wjb000/budget-humanoid/sim/README.md

# /sim: URDF, MuJoCo model and sim2real package for Budget-19

`budget19.xml`, `budget19.urdf`, `meshes/`, `joint_map.csv`, `mass_properties.json` are generated by `cad/sim_export.py` from the same CAD that produces the printable STLs. Do not hand-edit them; change `cad/` and re-export. Everything else here (actuator model, env, training, system-ID, domain randomisation) is hand-written and sits on top of them. **Read `SIM2REAL.md` for what is and is not validated.**

| File | What |
|---|---|
| `budget19.xml` | MuJoCo MJCF: 19 position actuators, IMU site + gyro/accelerometer/quaternion sensors, `head_cam` camera, `stand` keyframe |
| `budget19.urdf` | Same robot as URDF (Isaac Lab / Isaac Sim / PyBullet / ROS) |
| `meshes/*.obj` | Visual meshes per link in link-local frame, meters |
| `joint_map.csv` | Servo ID, joint name, parent/child, axis, safe limits, nominal limits, shaft location (mm, world) |
| `mass_properties.json` | Per-link mass, COM, inertia, and where each number came from |
| `check_mujoco.py` | Load + stand check at the zero pose |
| `actuator.py` | STS3215 model: torque-speed curve, supply sag, latency, dead band, quantisation, encoder hysteresis |
| `domain_randomization.json` | Randomisation ranges used by the env |
| `default_pose.py` / `default_pose.json` | Bent-knee ready pose (soles flat, COM over the soles) used as the policy's action offset |
| `obs.py` | Observation/action definition shared by training and the Pi runtime |
| `env.py` | Gymnasium + MuJoCo `stand` / `walk` environment |
| `train.py`, `export_policy.py`, `eval_policy.py` | PPO baseline (stable-baselines3), numpy export, evaluation vs a hold-pose baseline |
| `sysid.py` | Servo system-ID: record protocol (hardware), fit, and a synthetic selftest |

Units: meters, kilograms, radians. Zero pose = standing, arms down, legs straight. Link frames are world-aligned at the zero pose, with the origin on the joint shaft. Total mass 2.366 kg, COM about (-12, 2, 310) mm at the zero pose.

## Check it

```bash
pip install mujoco numpy scipy
python sim/check_mujoco.py                    # 5 s stand at the zero pose
python -m mujoco.viewer --mjcf=sim/budget19.xml
```

`check_mujoco.py` loads the MJCF, resets to the `stand` keyframe (all targets zero), steps 5 s, and reports center-of-mass sag, torso tilt, whether both foot soles are in contact, and actuator load as a fraction of the 2.94 N m servo stall torque. It exits non-zero if sag > 30 mm, tilt > 5 deg, or a foot loses contact. Result at the committed settings (kp 20, kv 0.5):

```
model: 21 bodies, 20 joints (1 free), 19 actuators, total mass 2.366 kg
after 5.0 s: COM z 0.309 m (start 0.312, max sag 2.8 mm), COM xy drift 4.8 mm
torso tilt: final 1.61 deg, max 1.94 deg; both feet in contact: True
RESULT: PASS - stands (position hold at zero pose)
```

This proves the model loads, the masses are sane and a stiff position hold at the zero pose is statically stable on the soles. It is not a balance controller or a walking result.

## Model details and conventions

- Joints: 19 revolute. Names `{r,l}_{hip_yaw,hip_roll,hip_pitch,knee,ankle_pitch,ankle_roll,shoulder_pitch,elbow,gripper}` plus `neck_yaw`. Servo IDs: right leg 1 to 6, left leg 7 to 12, right arm 13 to 15, left arm 16 to 18, neck 19.
- Axes and limits are per joint in `joint_map.csv`. The left side is the mirror of the right side with the **axis vector flipped**, so the same positive angle moves the left and right limb in opposite physical directions and the limits are mirrored (right knee flexes in the negative direction, left knee in the positive direction). **Use the axis column and limits per joint; do not assume left = right.** (A v2 bug where both knees and both grippers carried the same-sign limits, which let the right knee fold the wrong way, was found while building the policy default pose and fixed in `cad/robot.py`.)
- Servo models, one design: **STS3250 on hip pitch and knee (4 joints, 4.9 N m stall, 7.87 rad/s no-load, 74.5 g), STS3215 on the other 15 (2.94 N m, 4.72 rad/s, 55 g)**, both 12 V datasheet values (`joint_map.csv` columns `servo_model`, `stall_nm`, `rated_nm`, `noload_rad_s`). Masses in `mass_properties.json` use the right servo per joint.
- Actuators in the MJCF: `position` actuators with kp 20 N m/rad, kv 0.5 and the per-joint torque clamp above; joint damping 0.05, armature 0.02, friction loss 0.03. Starting values, not identified. The training env replaces these with torque motors driven by `actuator.py`.
- URDF effort/velocity limits are the per-joint stall torque and no-load speed. Rated (continuous) torque: 0.98 N m STS3215, 1.57 N m STS3250.
- Inertia: per link from the printed mesh (PLA 1.24 g/cc, 0.6 fill), the servo masses (55 g + 4 g hardware) and the electronics, with the parallel-axis theorem; `mass_properties.json` lists the parts.
- Contacts: **only the two foot soles collide** (a box per foot, friction 1.0). Torso, head and arms have no collision geometry and self-collision is off, so a fall passes through the floor. The training env ends an episode on tilt/height instead.
- Sensors: `imu` site at the BNO085 location with `imu_quat`, `imu_gyro`, `imu_acc`; `head_cam` at the head lens hole, 66 deg vertical FOV (assumed).

## Sim2real quick start

```bash
pip install mujoco numpy scipy gymnasium stable-baselines3 torch pyserial
python sim/default_pose.py                                   # (re)solve the ready pose
python sim/train.py --task stand --steps 600000 --out runs/stand0
python sim/train.py --task walk  --steps 3000000 --out runs/walk0
python sim/eval_policy.py runs/walk0 --task walk
python sim/sysid.py selftest                                 # fitting code check (synthetic data)
python deploy/test_deploy.py --policy runs/stand0            # runtime + framing against the ESP32 stand-in
```

## Isaac Lab notes

1. Convert the URDF to USD with Isaac Lab's `scripts/tools/convert_urdf.py`, `--fix-base` off, joint drive stiffness/damping 0 if you drive with your own actuator model. Meshes are OBJ in meters; keep `meshes/` next to the URDF.
2. First pass: per-joint `ImplicitActuatorCfg(effort_limit=<stall_nm>, velocity_limit=<noload_rad_s>, stiffness=20, damping=0.5)` (values in `joint_map.csv`), or a `DCMotorCfg(saturation_effort=<stall_nm>, effort_limit=<rated_nm>, velocity_limit=<noload_rad_s>)` once servo data exists. The stall number is not a continuous limit.
3. The URDF has foot collisions only (as the MJCF). Add torso/head/arm collision before enabling self-collision.
4. Use `obs.py` as the definition of the observation so a policy trained there matches `deploy/pi_runtime.py`; joint order is the MJCF actuator order (= `policy_meta.json: joint_order`).
5. Domain randomisation ranges: `domain_randomization.json`.
