wjb000/budget-humanoid/sim/joint_map.csv

servo_id | joint | parent_link | child_link | axis_x | axis_y | axis_z | lower_rad | upper_rad | nominal_lower | nominal_upper | shaft_x_mm | shaft_y_mm | shaft_z_mm | servo_model | stall_nm | rated_nm | noload_rad_s
1 | r_hip_yaw | base | r_hip_yaw_link | 0 | 0 | -1 | -0.56 | 0.28 | -0.6 | 0.6 | -40.0 | -55.0 | 317.0 | STS3215 | 2.94 | 0.98 | 4.72
2 | r_hip_roll | r_hip_yaw_link | r_hip_roll_link | 1 | 0 | 0 | -0.24 | 0.2 | -0.5 | 0.5 | -28.2 | -55.0 | 275.0 | STS3215 | 2.94 | 0.98 | 4.72
3 | r_hip_pitch | r_hip_roll_link | r_thigh | 0 | -1 | 0 | -0.6 | 0.95 | -1.0 | 1.0 | 0.0 | -66.0 | 275.0 | STS3250 | 4.9 | 1.57 | 7.87
4 | r_knee | r_thigh | r_shin | 0 | -1 | 0 | -1.9 | 0.09 | -2.0 | 0.1 | 0.0 | -107.6 | 175.0 | STS3250 | 4.9 | 1.57 | 7.87
5 | r_ankle_pitch | r_shin | r_ankle_link | 0 | 1 | 0 | -0.76 | 0.76 | -0.8 | 0.8 | 0.0 | -70.2 | 78.0 | STS3215 | 2.94 | 0.98 | 4.72
6 | r_ankle_roll | r_ankle_link | r_foot | 1 | 0 | 0 | -0.33 | 0.33 | -0.35 | 0.35 | 22.0 | -55.0 | 25.0 | STS3215 | 2.94 | 0.98 | 4.72
7 | l_hip_yaw | base | l_hip_yaw_link | 0 | 0 | -1 | -0.28 | 0.56 | -0.6 | 0.6 | -40.0 | 55.0 | 317.0 | STS3215 | 2.94 | 0.98 | 4.72
8 | l_hip_roll | l_hip_yaw_link | l_hip_roll_link | 1 | 0 | 0 | -0.2 | 0.24 | -0.5 | 0.5 | -28.2 | 55.0 | 275.0 | STS3215 | 2.94 | 0.98 | 4.72
9 | l_hip_pitch | l_hip_roll_link | l_thigh | 0 | 1 | 0 | -0.95 | 0.6 | -1.0 | 1.0 | 0.0 | 66.0 | 275.0 | STS3250 | 4.9 | 1.57 | 7.87
10 | l_knee | l_thigh | l_shin | 0 | 1 | 0 | -0.09 | 1.9 | -0.1 | 2.0 | 0.0 | 107.6 | 175.0 | STS3250 | 4.9 | 1.57 | 7.87
11 | l_ankle_pitch | l_shin | l_ankle_link | 0 | -1 | 0 | -0.76 | 0.76 | -0.8 | 0.8 | 0.0 | 70.2 | 78.0 | STS3215 | 2.94 | 0.98 | 4.72
12 | l_ankle_roll | l_ankle_link | l_foot | 1 | 0 | 0 | -0.33 | 0.33 | -0.35 | 0.35 | 22.0 | 55.0 | 25.0 | STS3215 | 2.94 | 0.98 | 4.72
13 | r_shoulder_pitch | base | r_upper_arm | 0 | -1 | 0 | -1.9 | 1.9 | -2.0 | 2.0 | -22.4 | -93.5 | 440.0 | STS3215 | 2.94 | 0.98 | 4.72
14 | r_elbow | r_upper_arm | r_forearm | 0 | 1 | 0 | -1.42 | 1.42 | -1.5 | 1.5 | 16.5 | -90.7 | 359.0 | STS3215 | 2.94 | 0.98 | 4.72
15 | r_gripper | r_forearm | r_finger | 0 | -1 | 0 | -0.47 | 0.11 | -0.5 | 0.2 | 16.5 | -128.1 | 305.0 | STS3215 | 2.94 | 0.98 | 4.72
16 | l_shoulder_pitch | base | l_upper_arm | 0 | 1 | 0 | -1.9 | 1.9 | -2.0 | 2.0 | -22.4 | 93.5 | 440.0 | STS3215 | 2.94 | 0.98 | 4.72
17 | l_elbow | l_upper_arm | l_forearm | 0 | -1 | 0 | -1.42 | 1.42 | -1.5 | 1.5 | 16.5 | 90.7 | 359.0 | STS3215 | 2.94 | 0.98 | 4.72
18 | l_gripper | l_forearm | l_finger | 0 | 1 | 0 | -0.11 | 0.47 | -0.2 | 0.5 | 16.5 | 128.1 | 305.0 | STS3215 | 2.94 | 0.98 | 4.72
19 | neck_yaw | base | head | 0 | 0 | 1 | -1.13 | 1.13 | -1.2 | 1.2 | -40.0 | 0.0 | 541.5 | STS3215 | 2.94 | 0.98 | 4.72
