wjb000/budget-humanoid/cad/step/torso_front_cover.step

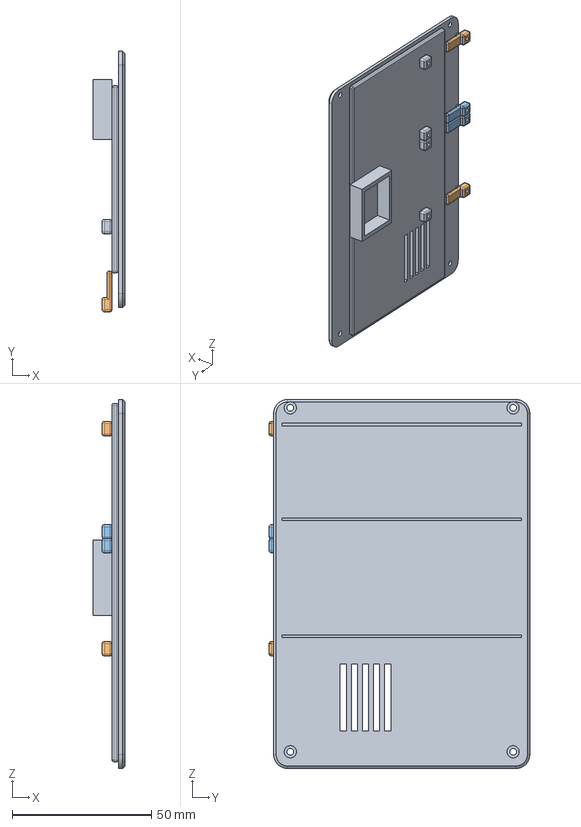
[picture p1: CAD file, 2026-11-10]
cad/step/torso_front_cover.step
11.6 x 93.6 x 132.5 mm
