wjb000/budget-humanoid/sim/meshes/r_upper_arm.obj

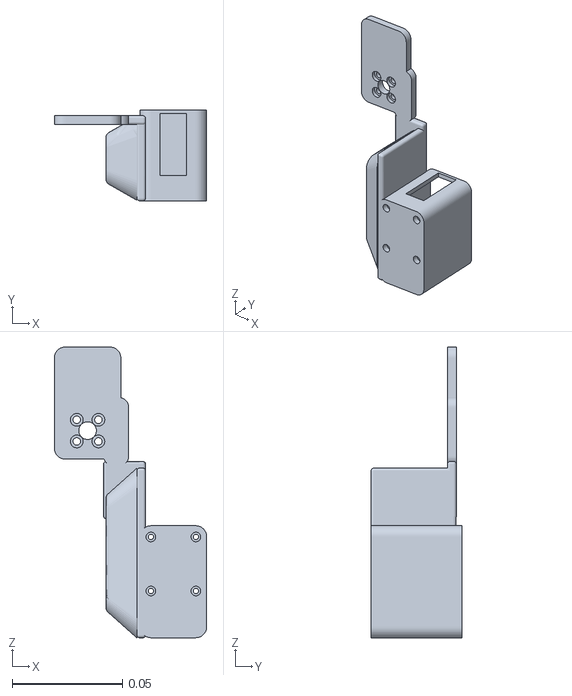
[picture p2: CAD file, 2026-11-10]
sim/meshes/r_upper_arm.obj
0.0691 x 0.0411 x 0.132
