wjb000/budget-humanoid/cad/step/torso.step

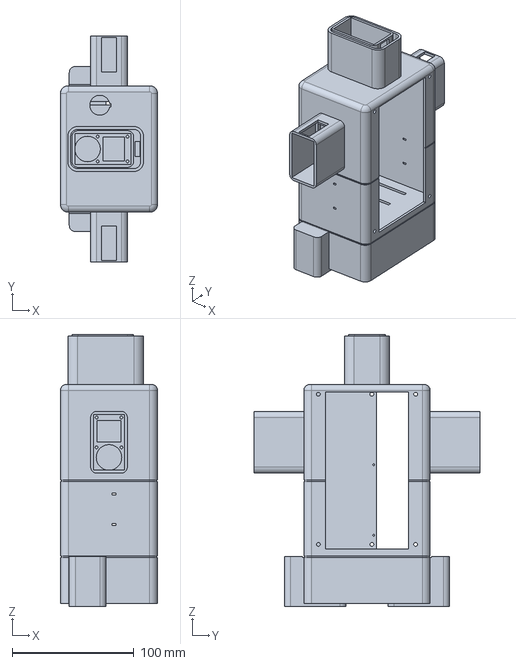
[picture p3: CAD file, 2026-11-10]
cad/step/torso.step
80.0 x 186.2 x 223.7 mm
