wjb000/budget-humanoid/sim/meshes/r_shin.obj

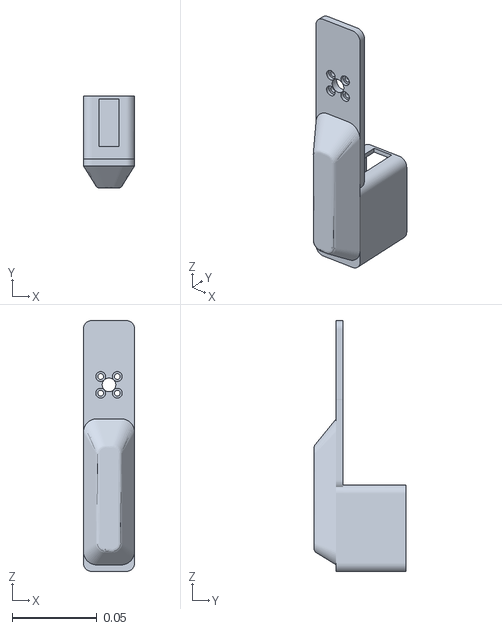
[picture p4: CAD file, 2026-11-10]
sim/meshes/r_shin.obj
0.0302 x 0.0541 x 0.148
