wjb000/budget-humanoid/cad/step/r_upper_arm.step

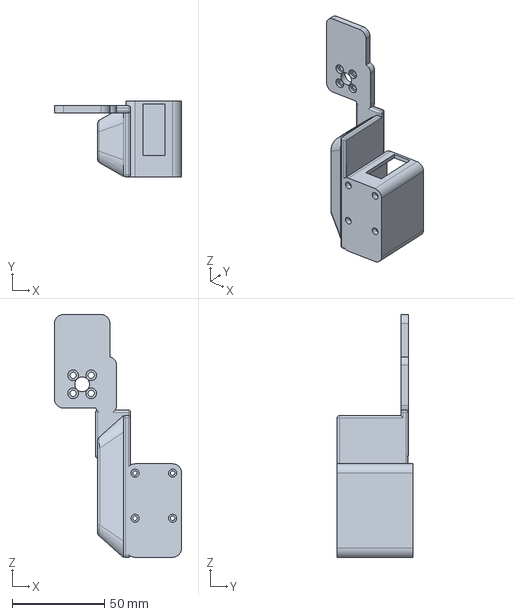
[picture p5: CAD file, 2026-11-10]
cad/step/r_upper_arm.step
69.1 x 41.1 x 131.9 mm
