wjb000/budget-humanoid/sim/meshes/r_thigh.obj

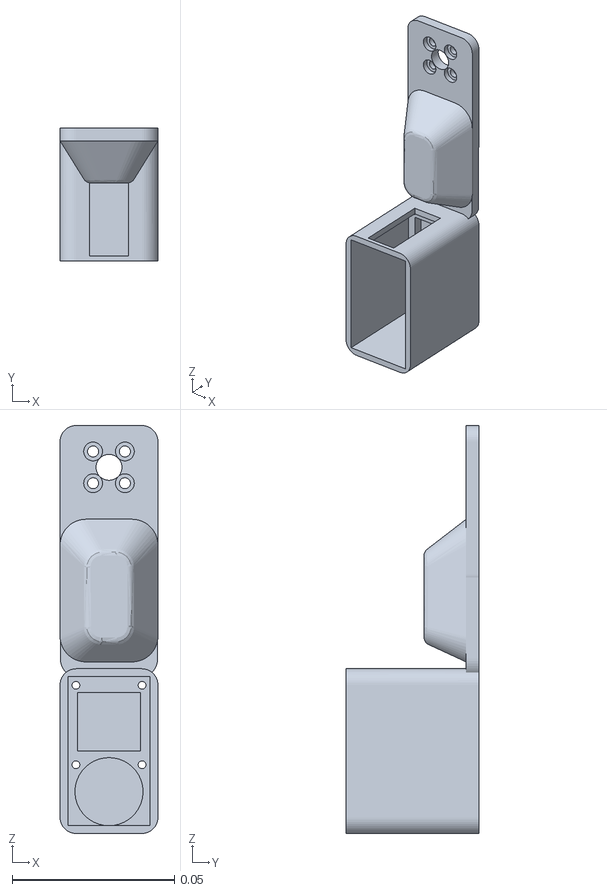
[picture p6: CAD file, 2026-11-10]
sim/meshes/r_thigh.obj
0.0302 x 0.0411 x 0.126
