wjb000/budget-humanoid/cad/step/r_thigh.step

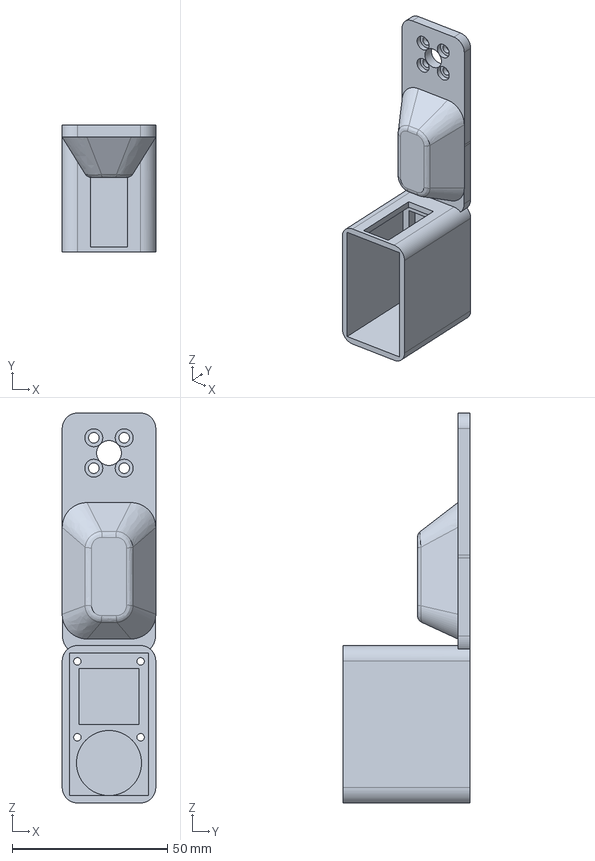
[picture p7: CAD file, 2026-11-10]
cad/step/r_thigh.step
30.2 x 41.1 x 125.8 mm
