wjb000/budget-humanoid/sim/meshes/r_forearm.obj

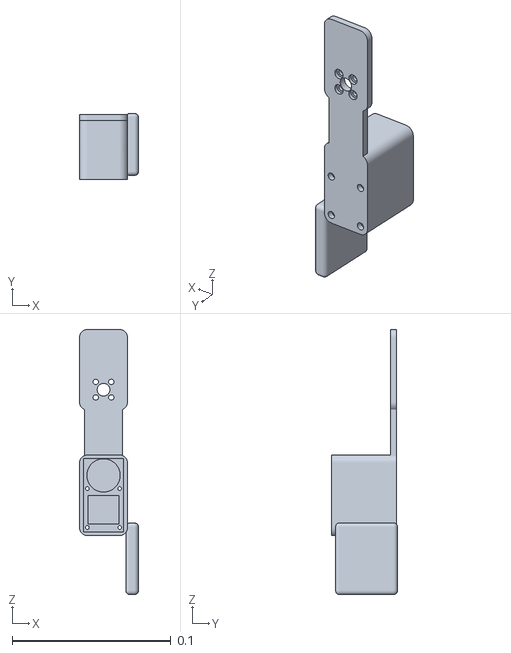
[picture p8: CAD file, 2026-11-10]
sim/meshes/r_forearm.obj
0.0371 x 0.0416 x 0.167
