wjb000/budget-humanoid/cad/step/r_shin.step

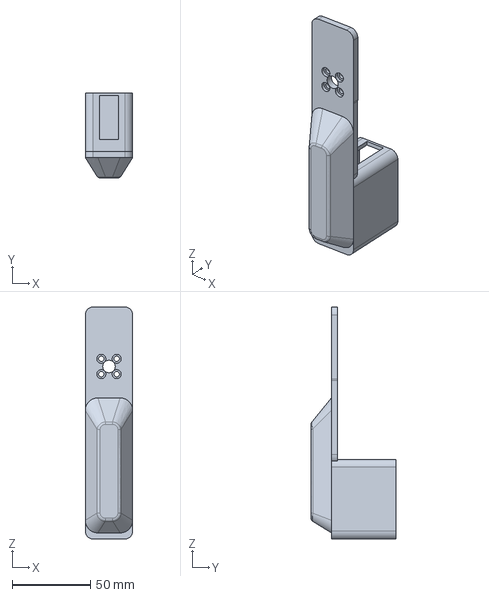
[picture p9: CAD file, 2026-11-10]
cad/step/r_shin.step
30.2 x 54.1 x 147.8 mm
