wjb000/budget-humanoid/sim/meshes/r_foot.obj

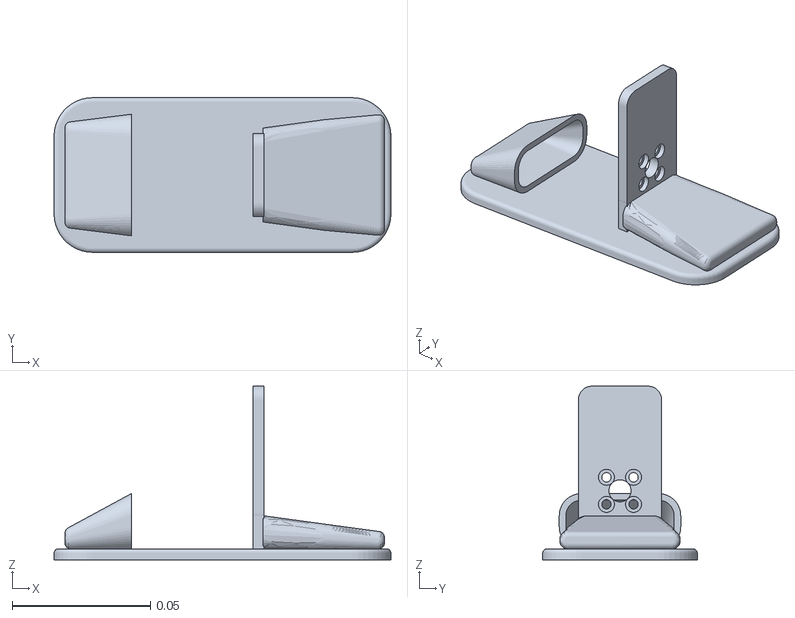
[picture p10: CAD file, 2026-11-10]
sim/meshes/r_foot.obj
0.122 x 0.056 x 0.0629
