wjb000/budget-humanoid/cad/step/r_hip_roll_link.step

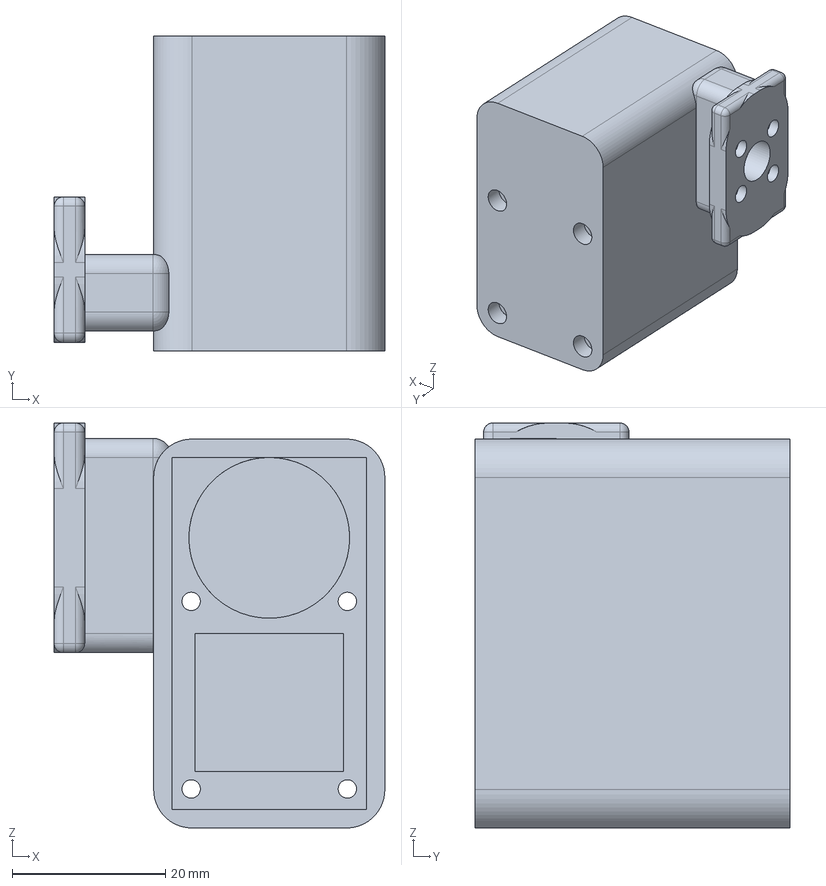
[picture p11: CAD file, 2026-11-10]
cad/step/r_hip_roll_link.step
43.2 x 41.1 x 52.9 mm
