wjb000/budget-humanoid/sim/meshes/r_hip_yaw_link.obj

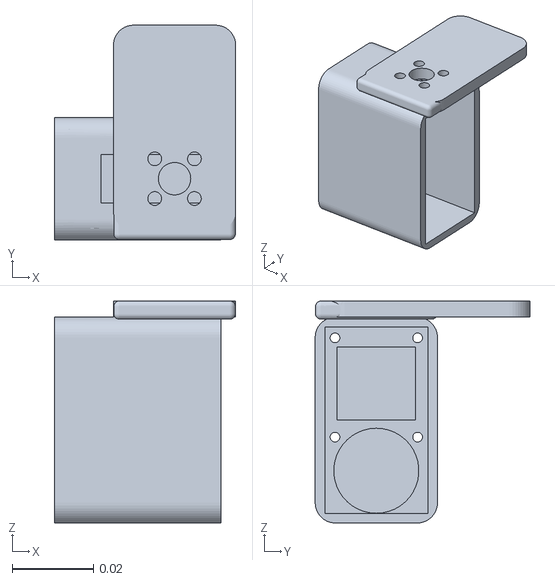
[picture p12: CAD file, 2026-11-10]
sim/meshes/r_hip_yaw_link.obj
0.0448 x 0.053 x 0.0548
