wjb000/budget-humanoid/cad/step/r_hip_yaw_link.step

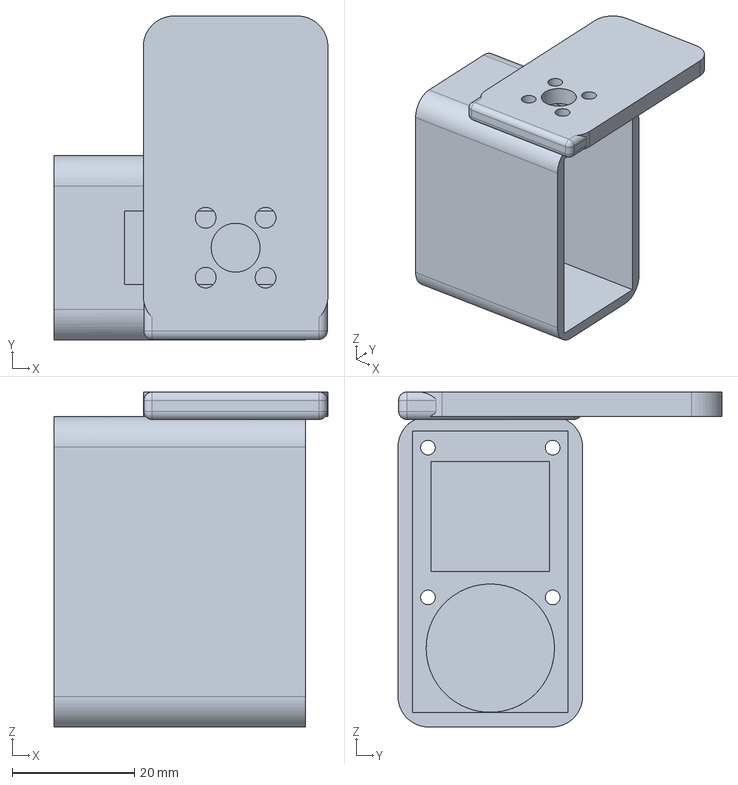
[picture p13: CAD file, 2026-11-10]
cad/step/r_hip_yaw_link.step
44.8 x 53.0 x 54.8 mm
