wjb000/budget-humanoid/sim/meshes/r_hip_roll_link.obj

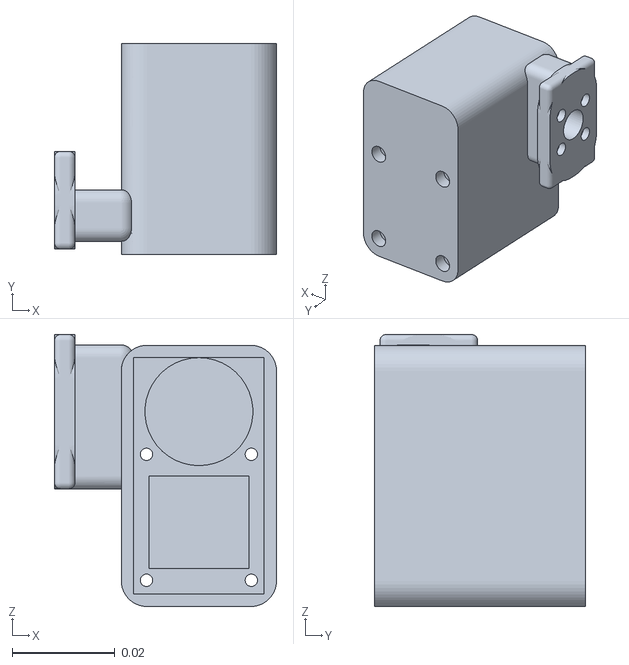
[picture p14: CAD file, 2026-11-10]
sim/meshes/r_hip_roll_link.obj
0.0432 x 0.0411 x 0.0529
