wjb000/budget-humanoid/cad/step/r_foot.step

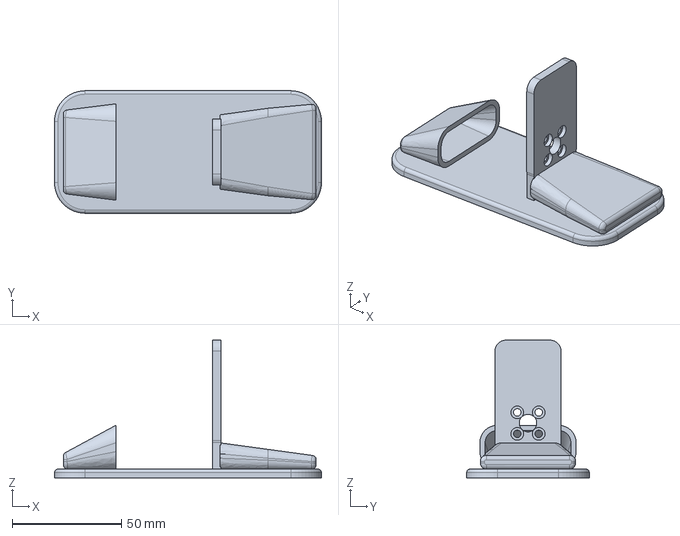
[picture p15: CAD file, 2026-11-10]
cad/step/r_foot.step
122.0 x 56.0 x 62.9 mm
