wjb000/budget-humanoid/cad/step/r_forearm.step

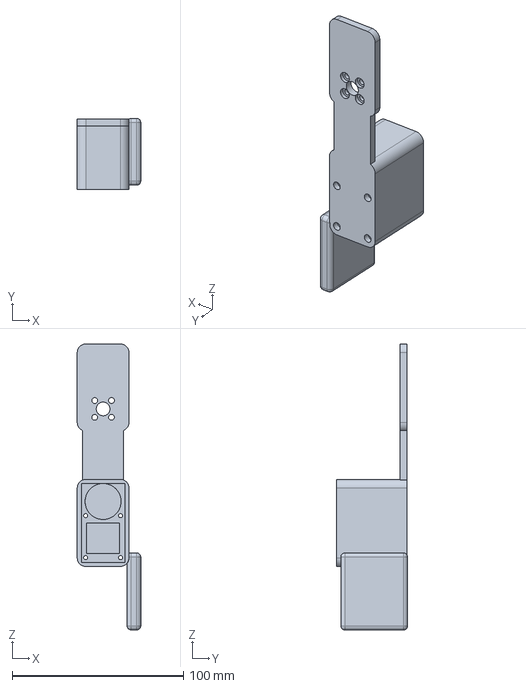
[picture p17: CAD file, 2026-11-10]
cad/step/r_forearm.step
37.1 x 41.6 x 166.9 mm
