wjb000/budget-humanoid/cad/step/r_ankle_link.step

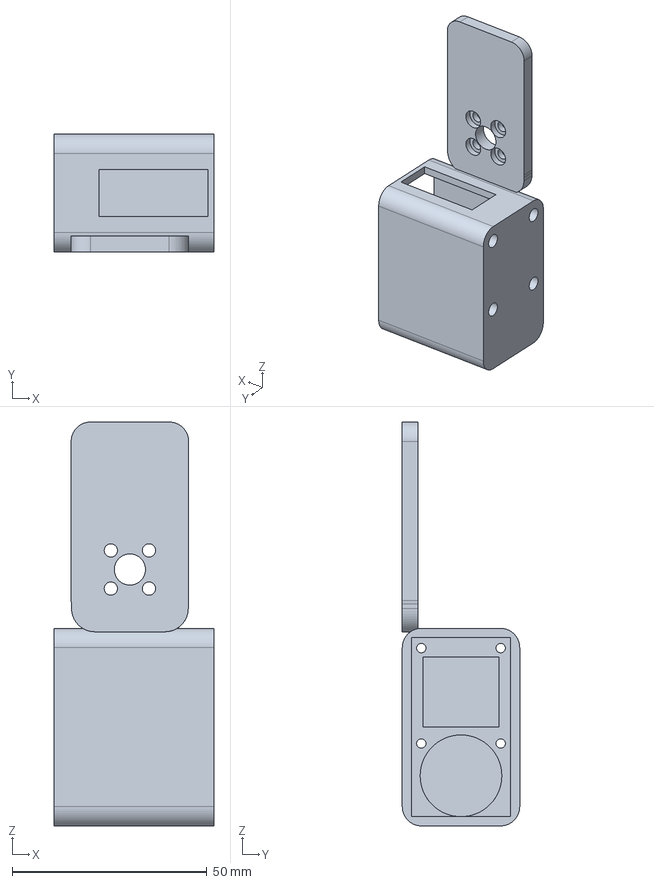
[picture p18: CAD file, 2026-11-10]
cad/step/r_ankle_link.step
41.1 x 30.2 x 103.8 mm
