wjb000/budget-humanoid/sim/meshes/r_finger.obj

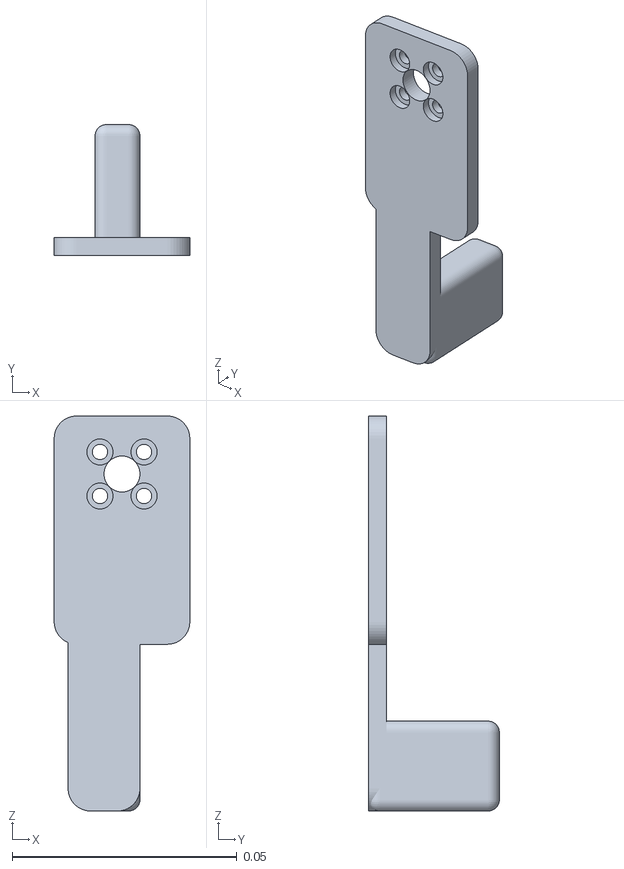
[picture p19: CAD file, 2026-11-10]
sim/meshes/r_finger.obj
0.0302 x 0.0291 x 0.0879
