wjb000/budget-humanoid/cad/step/r_finger.step

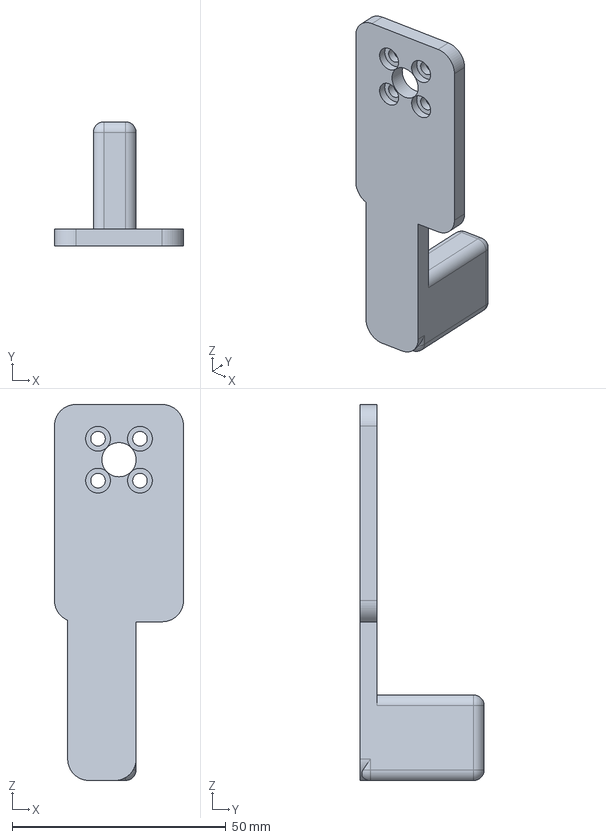
[picture p20: CAD file, 2026-11-10]
cad/step/r_finger.step
30.2 x 29.1 x 87.9 mm
