wjb000/budget-humanoid/sim/meshes/head.obj

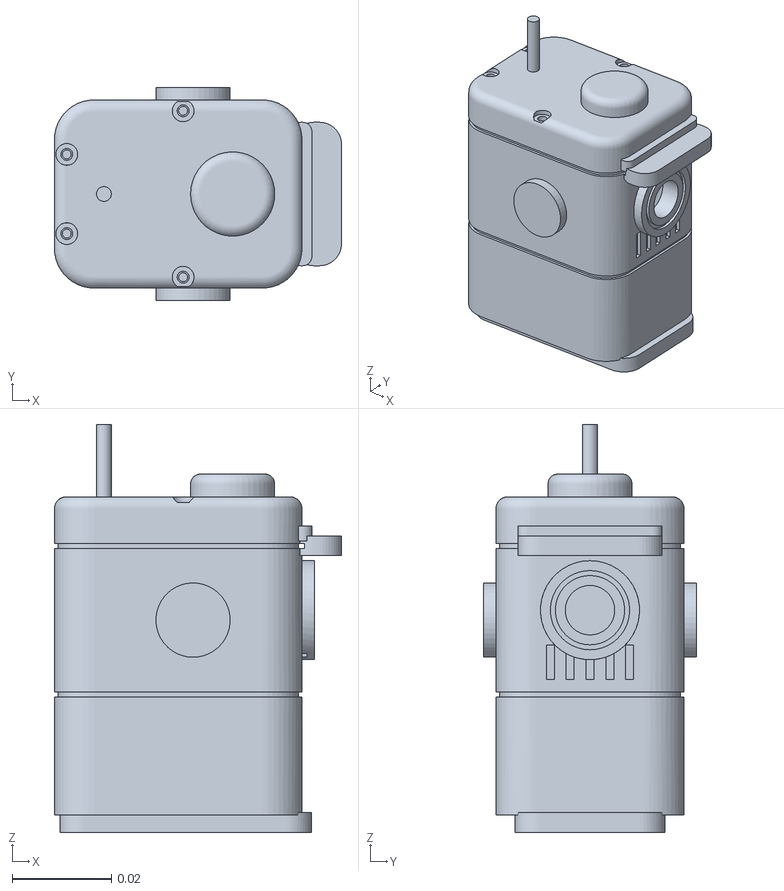
[picture p21: CAD file, 2026-11-10]
sim/meshes/head.obj
0.058 x 0.043 x 0.0824
