wjb000/budget-humanoid/cad/step/head_lid.step

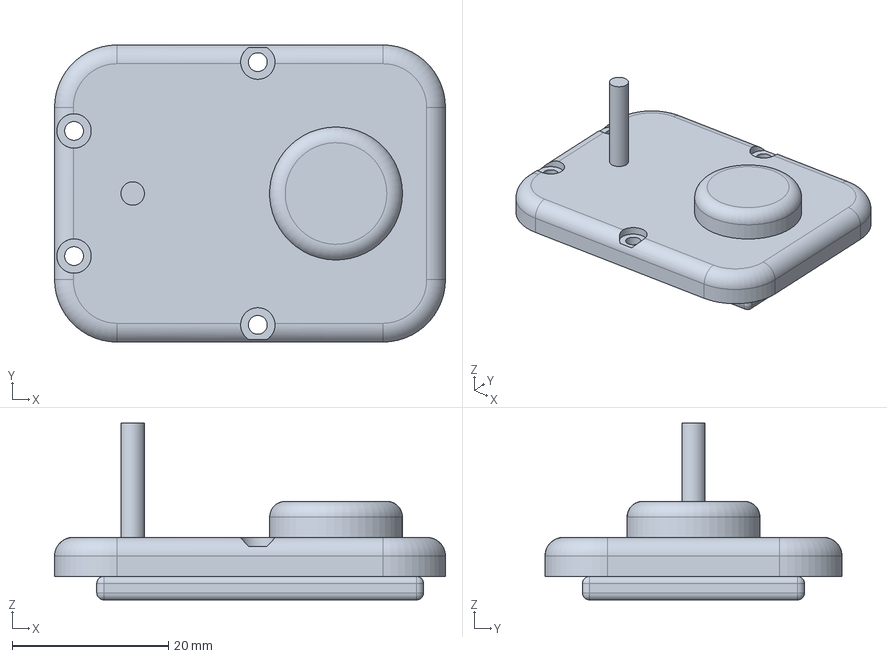
[picture p22: CAD file, 2026-11-10]
cad/step/head_lid.step
50.0 x 38.0 x 22.6 mm
