wjb000/budget-humanoid/sim/meshes/base.obj

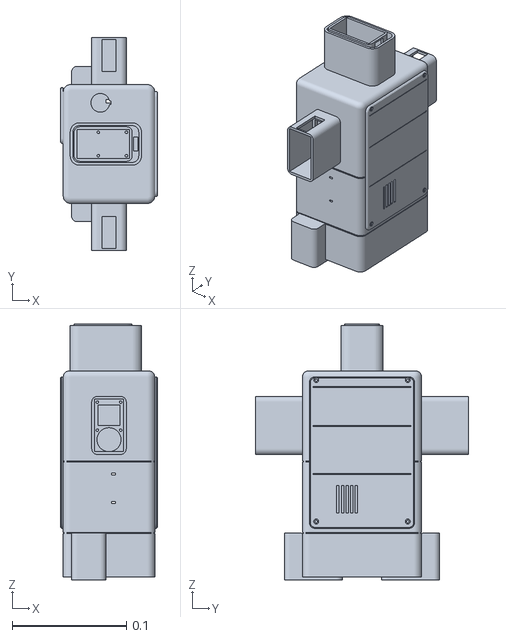
[picture p23: CAD file, 2026-11-10]
sim/meshes/base.obj
0.0848 x 0.186 x 0.224
