wjb000/budget-humanoid/cad/step/head.step

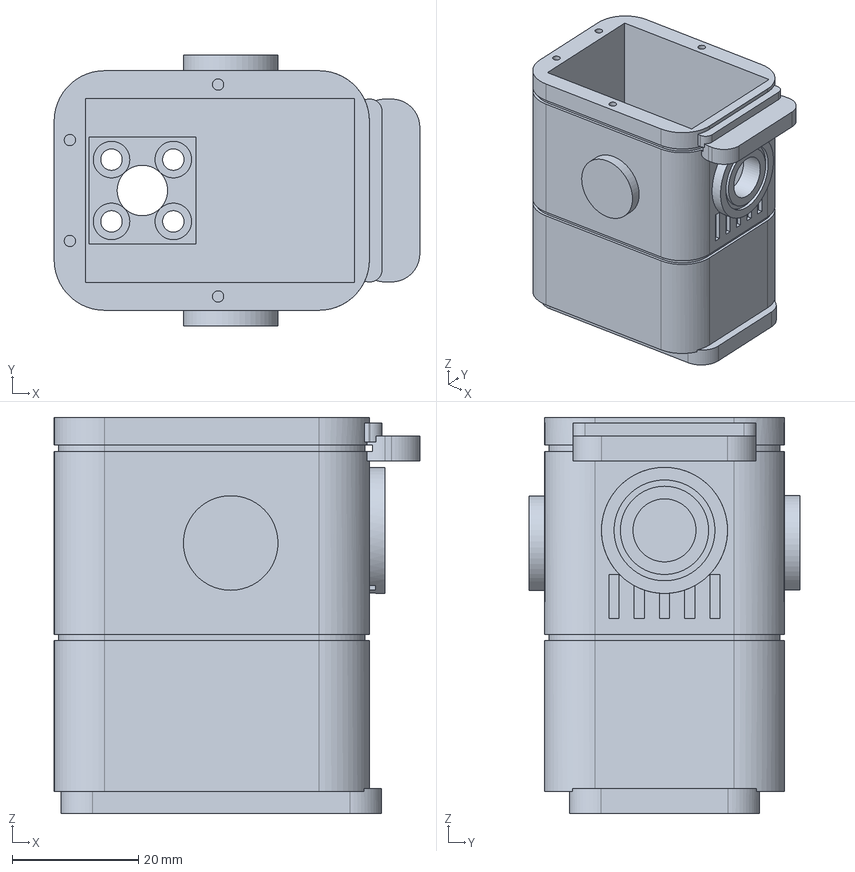
[picture p24: CAD file, 2026-11-10]
cad/step/head.step
58.0 x 43.0 x 62.8 mm
