wjb000/budget-humanoid/sim/meshes/r_shoulder_link.obj

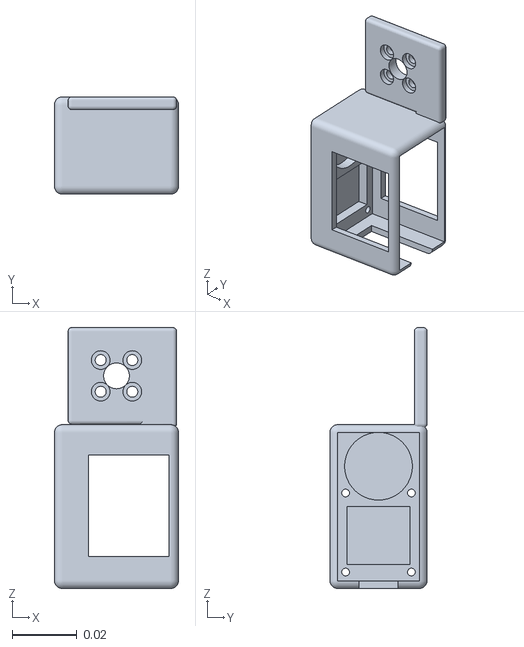
[picture p25: CAD file, 2026-11-10]
sim/meshes/r_shoulder_link.obj
0.0385 x 0.0302 x 0.0809
