wjb000/budget-humanoid/cad/step/battery_door.step

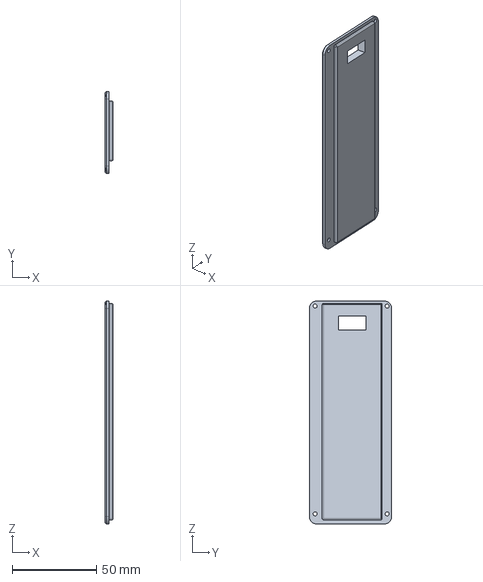
[picture p26: CAD file, 2026-11-10]
cad/step/battery_door.step
4.80 x 49.0 x 132.5 mm
