wjb000/budget-humanoid/sim/meshes/neck_bracket.obj

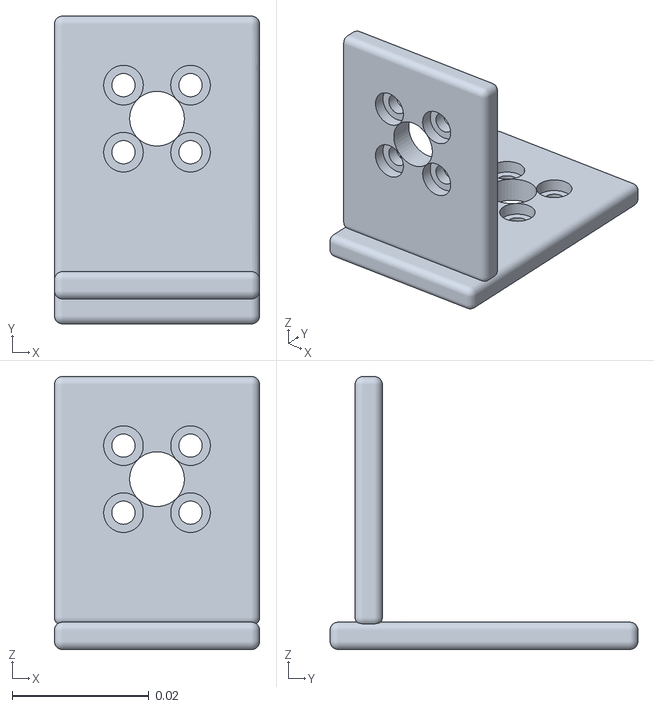
[picture p27: CAD file, 2026-11-10]
sim/meshes/neck_bracket.obj
0.03 x 0.045 x 0.0399
