wjb000/budget-humanoid/cad/step/r_shoulder_link.step

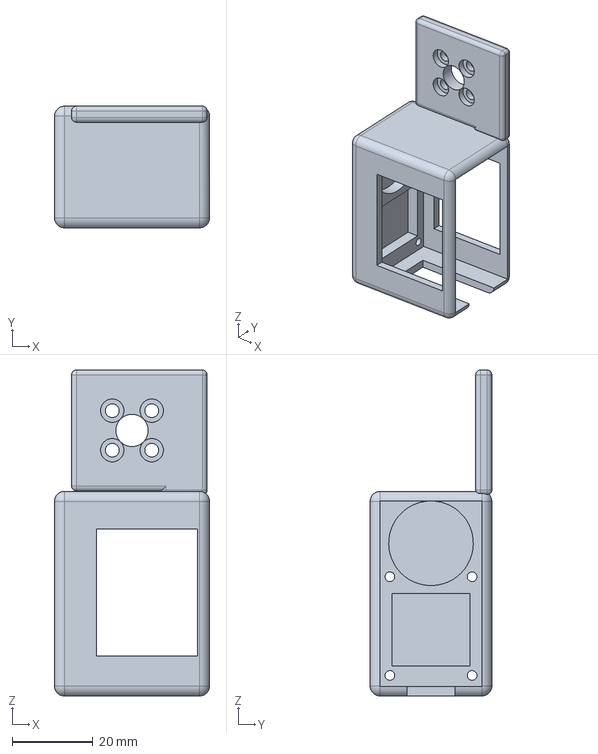
[picture p28: CAD file, 2026-11-10]
cad/step/r_shoulder_link.step
38.5 x 30.2 x 80.9 mm
