wjb000/budget-humanoid/sim/meshes/sts3215.obj

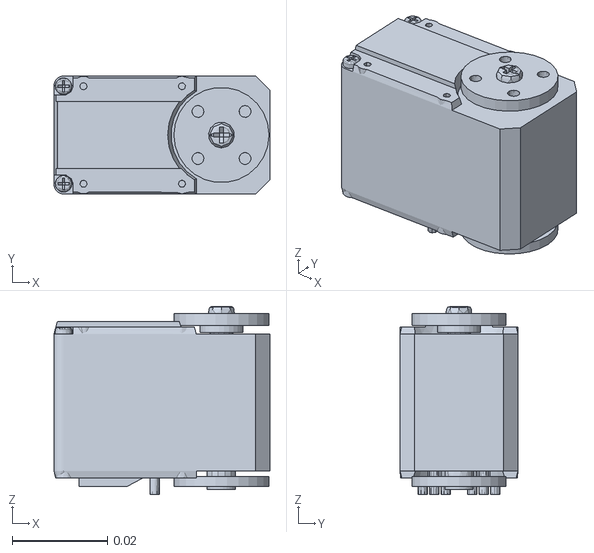
[picture p29: CAD file, 2026-11-10]
sim/meshes/sts3215.obj
0.0454 x 0.0248 x 0.0396
