wjb000/budget-humanoid/cad/step/pelvis.step

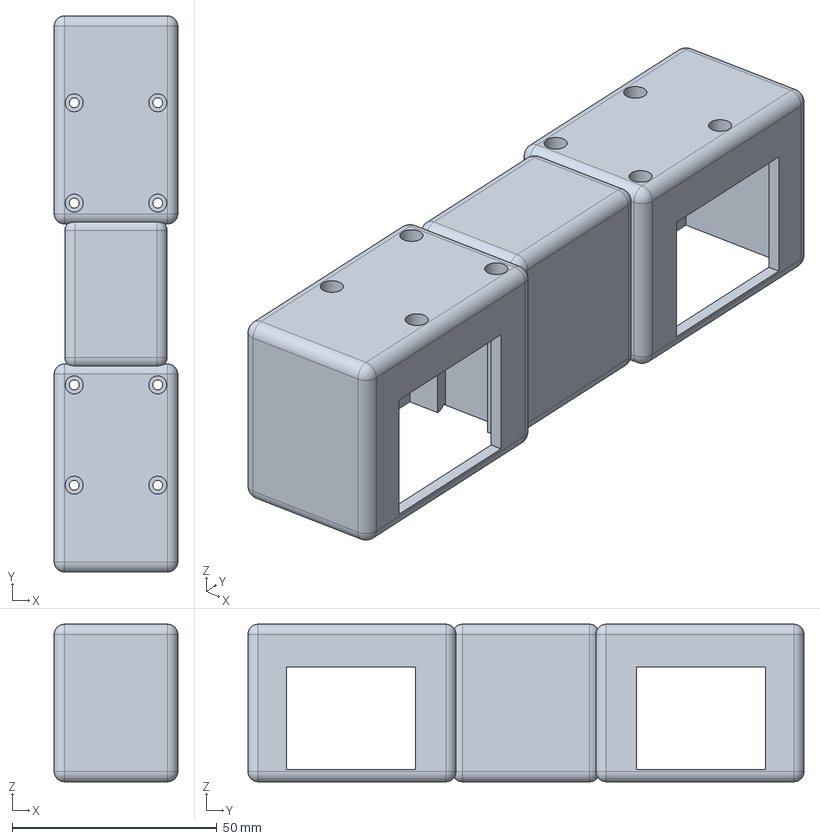
[picture p30: CAD file, 2026-11-10]
cad/step/pelvis.step
30.2 x 135.8 x 38.5 mm
