wjb000/budget-humanoid/cad/step/neck_bracket.step

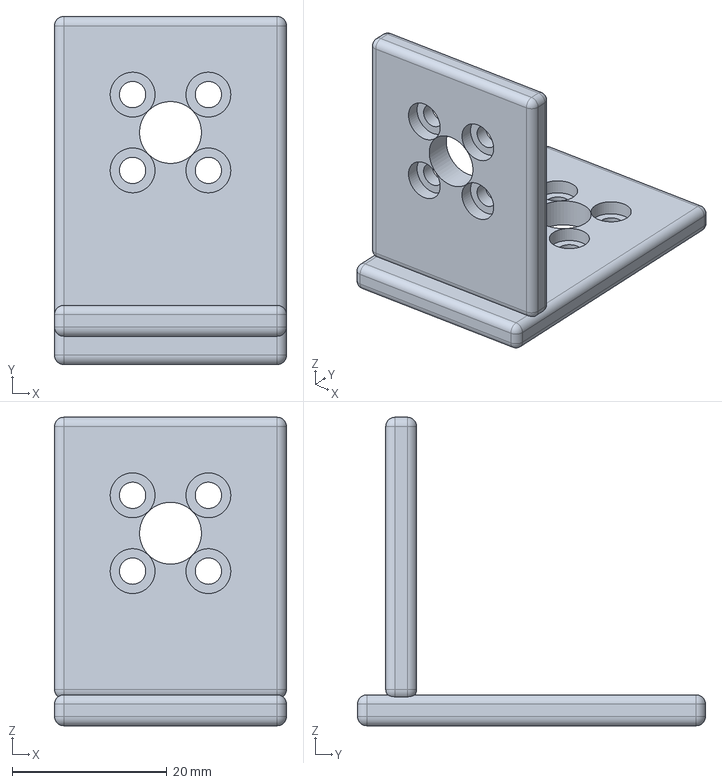
[picture p31: CAD file, 2026-11-10]
cad/step/neck_bracket.step
30.0 x 45.0 x 39.9 mm
