wjb000/budget-humanoid/cad/step/fit_coupon_sleeve.step

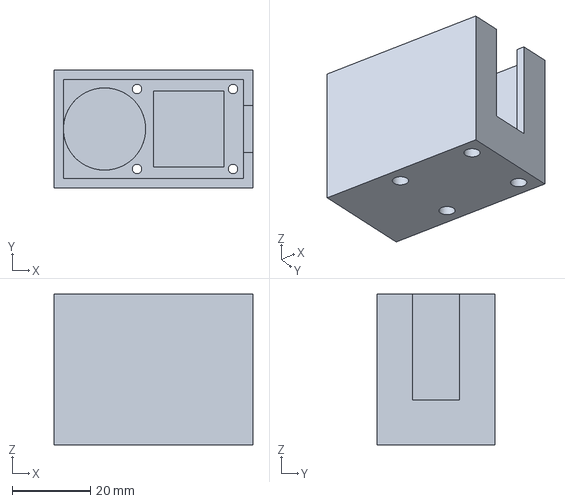
[picture p32: CAD file, 2026-11-10]
cad/step/fit_coupon_sleeve.step
50.8 x 30.2 x 38.5 mm
