wjb000/budget-humanoid/cad/step/fit_coupon_plate.step

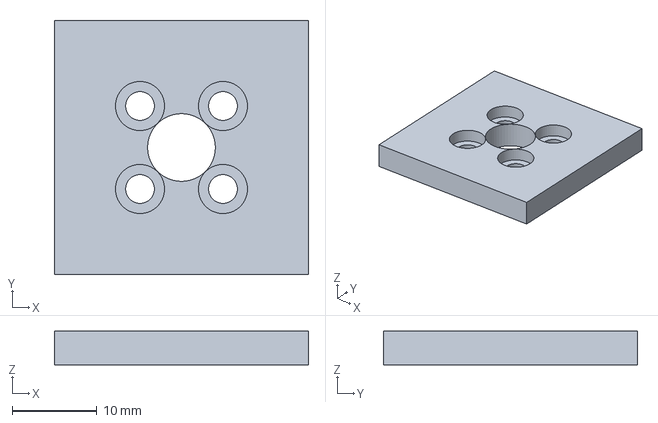
[picture p33: CAD file, 2026-11-10]
cad/step/fit_coupon_plate.step
30.0 x 30.0 x 4.00 mm
