wjb000/budget-humanoid/(list of files, cad)

Other CAD files:
sim/meshes/l_upper_arm.obj
sim/meshes/l_thigh.obj
cad/step/l_upper_arm.step
sim/meshes/l_hip_roll_link.obj
cad/step/l_thigh.step
sim/meshes/l_shin.obj
cad/step/l_shin.step
sim/meshes/l_hip_yaw_link.obj
cad/step/l_hip_roll_link.step
sim/meshes/l_forearm.obj
cad/step/l_hip_yaw_link.step
sim/meshes/l_ankle_link.obj
cad/step/l_foot.step
cad/step/l_forearm.step
sim/meshes/l_finger.obj
cad/step/l_finger.step
sim/meshes/l_foot.obj
cad/step/l_ankle_link.step
sim/meshes/l_shoulder_link.obj
cad/step/l_shoulder_link.step
cad/stl/battery_door.stl
cad/stl/fit_coupon_plate.stl
cad/stl/fit_coupon_sleeve.stl
cad/stl/head.stl
cad/stl/head_lid.stl
cad/stl/l_ankle_link.stl
cad/stl/l_finger.stl
cad/stl/l_foot.stl
cad/stl/l_forearm.stl
cad/stl/l_hip_roll_link.stl
cad/stl/l_hip_yaw_link.stl
cad/stl/l_shin.stl
cad/stl/l_shoulder_link.stl
cad/stl/l_thigh.stl
cad/stl/l_upper_arm.stl
cad/stl/neck_bracket.stl
cad/stl/pelvis.stl
cad/stl/r_ankle_link.stl
cad/stl/r_finger.stl
cad/stl/r_foot.stl
cad/stl/r_forearm.stl
cad/stl/r_hip_roll_link.stl
cad/stl/r_hip_yaw_link.stl
cad/stl/r_shin.stl
cad/stl/r_shoulder_link.stl
cad/stl/r_thigh.stl
cad/stl/r_upper_arm.stl
cad/stl/torso.stl
cad/stl/torso_front_cover.stl
