wjb000/budget-humanoid/cad/PRINT_GUIDE.md

# Print guide: Budget-19 printed frame

23 printed parts, one STL each in `cad/stl/` (ASCII STL, mm). **Every STL is already rotated into its print orientation and sits on z = 0**: import, do not rotate. Left/right parts are separate mirrored files, so print one of each file. Matching STEP files (assembly frame, for CAD work) are in `cad/step/`.

Status: **designed and checked in software only** (watertight meshes, 220 x 220 mm bed fit, collision-free zero pose, wall check). It has **not been printed or assembled** yet. Print the fit coupons first.

## 0. Fit test first (about 15 to 25 g, well under an hour)

```
python cad/fit_coupon.py          # writes cad/stl/fit_coupon_sleeve.stl and fit_coupon_plate.stl
```

1. `fit_coupon_sleeve`: a real STS3215 must drop into the pocket with the 4 case-screw holes lining up with the servo's case holes and the cable notch clear. Print **opening up**.
2. `fit_coupon_plate`: must sit on the servo horn with its 4 counterbored holes over the horn's 4 holes (9.8 mm square pattern).

The horn hole pattern, case-screw positions and cable-slot position were **measured from the SO-ARM100 STS3215 STEP**, not from a physical servo. If a coupon is off, change `HORN_PATTERN`, `CASE_HOLES`, `CLR` or `GAP` in `cad/lib.py`, run `python cad/export.py`, and every part updates.

## 1. Settings

| | |
|---|---|
| Printer | any FDM, 220 x 220 mm bed or larger (largest part: torso, see table) |
| Material | PLA+ or PETG for the frame. PETG for feet, ankle and shin (impact, creep). Not plain PLA near the battery or in a hot car. |
| Nozzle / layer | 0.4 mm / 0.2 mm |
| Perimeters | 4 (1.6 mm) minimum; designed wall is 2.0 to 2.4 mm |
| Infill | 20% gyroid; 40% for the load-bearing leg parts (thigh, shin, ankle link, foot) |
| Top/bottom | 5 layers |
| Supports | Mostly none: overhang area is under 12% on every part (forearm is the worst). The pockets open toward +z or sideways; turn on "supports touching build plate" or tree supports and read the preview for torso and forearm. |
| Tolerance | pocket clearance 0.3 mm per side, horn-plate gap 0.1 mm (set in `cad/lib.py`) |
| Printed mass | about 746 g estimated (60% effective fill), roughly 23 parts |

## 2. Parts

| Part | Qty | Servos it carries | Print size (mm) | Overhang | Est. mass* | Supports |
|---|---|---|---|---|---|---|
| `r_foot` | 1 | - | 122 x 63 x 56 | 5.1% | 36 g | supports on cable/screw pockets (see preview) |
| `r_ankle_link` | 1 | r_ankle_roll | 104 x 30 x 41 | 2.0% | 18 g | none needed |
| `r_shin` | 1 | r_ankle_pitch | 30 x 54 x 148 | 4.8% | 28 g | tree/touching-bed supports, check preview |
| `r_thigh` | 1 | r_knee | 30 x 126 x 41 | 1.8% | 23 g | none needed |
| `r_hip_roll_link` | 1 | r_hip_pitch | 43 x 53 x 41 | 3.2% | 17 g | tree/touching-bed supports, check preview |
| `r_hip_yaw_link` | 1 | r_hip_roll | 55 x 53 x 45 | 2.0% | 18 g | none needed |
| `r_upper_arm` | 1 | r_elbow | 69 x 41 x 132 | 8.3% | 31 g | supports on cable/screw pockets (see preview) |
| `r_forearm` | 1 | r_gripper | 37 x 42 x 167 | 8.9% | 30 g | supports on cable/screw pockets (see preview) |
| `r_finger` | 1 | - | 30 x 88 x 29 | 1.1% | 10 g | none needed |
| `l_foot` | 1 | - | 122 x 63 x 56 | 5.1% | 36 g | supports on cable/screw pockets (see preview) |
| `l_ankle_link` | 1 | l_ankle_roll | 104 x 30 x 41 | 2.0% | 18 g | none needed |
| `l_shin` | 1 | l_ankle_pitch | 30 x 54 x 148 | 4.8% | 28 g | tree/touching-bed supports, check preview |
| `l_thigh` | 1 | l_knee | 30 x 126 x 41 | 1.8% | 23 g | none needed |
| `l_hip_roll_link` | 1 | l_hip_pitch | 43 x 53 x 41 | 3.2% | 17 g | tree/touching-bed supports, check preview |
| `l_hip_yaw_link` | 1 | l_hip_roll | 55 x 53 x 45 | 2.0% | 18 g | none needed |
| `l_upper_arm` | 1 | l_elbow | 69 x 41 x 132 | 8.4% | 31 g | supports on cable/screw pockets (see preview) |
| `l_forearm` | 1 | l_gripper | 37 x 42 x 167 | 8.9% | 30 g | supports on cable/screw pockets (see preview) |
| `l_finger` | 1 | - | 30 x 88 x 29 | 1.1% | 10 g | none needed |
| `torso` | 1 | r_hip_yaw, l_hip_yaw, r_shoulder_pitch, l_shoulder_pitch, neck_yaw | 80 x 186 x 224 | 10.3% | 214 g | supports on cable/screw pockets (see preview) |
| `head` | 1 | - | 58 x 43 x 63 | 4.4% | 44 g | tree/touching-bed supports, check preview |
| `torso_front_cover` | 1 | - | 12 x 94 x 132 | 3.2% | 37 g | tree/touching-bed supports, check preview |
| `battery_door` | 1 | - | 5 x 49 x 132 | 1.6% | 19 g | none needed |
| `head_lid` | 1 | - | 23 x 38 x 50 | 5.2% | 10 g | supports on cable/screw pockets (see preview) |

\* Mass estimate = solid volume x 1.24 g/cc (PLA) x 0.6 effective fill. Weigh your parts and update `PLA_DENSITY`/`FILL` in `cad/export.py` so the sim masses match.

## 3. Hardware (not printed)

- 15 x Feetech STS3215 (30 kg.cm) and 4 x Feetech STS3250 (50 kg.cm) servos. The STS3250 goes on hip pitch (IDs 3, 9) and knee (IDs 4, 10). Both are 45.2 x 24.7 x 35 mm with the same 25T horn, so the pods are the same; the STS3250 mounting holes were not checked against a physical unit, so run the sleeve coupon with an STS3250 too.
- 4 x M2 screws per servo for the sleeve (case holes), self-tapping into the servo case, length about 8 to 10 mm (confirm with the sleeve coupon)
- 4 x M3 screws per servo for the horn plate (the plate holes are counterbored from the outside), length about 8 mm. Confirm against your servo's horn.
- **Fasteners are M2 and M3 only.**
  - Servo sleeves: 4 x M2 x 8 per servo (76 for 19 servos), self-tapping into the servo case. Horn plates: 4 x M3 x 8 per servo (76), plate holes counterbored from outside. Confirm both against the coupons and your servo.
  - Torso front cover: 4 x M2 x 6 into 4 x M2 heat-set inserts (pockets 3.2 mm, 6.5 mm deep) in the front bosses. Battery door: 4 x M2 x 6 into 4 more inserts. That is 8 inserts and 8 screws.
  - Head lid: 4 x M2 x 8 self-tapping into 1.8 mm pilot holes (2 in the head's back wall, 2 in its side walls).
  - Pi 5: 4 x M2 x 8 self-tapping into 1.7 mm pilot holes in the 4 torso standoffs. The Pi's own holes are M2.5 (2.75 mm), so M2 screws fit loosely; they hold, they do not locate. Check and shim if the board rocks.
  - Waveshare bus adapters A and B: 4 x M2 x 6 each into 8 M2 self-tapping bosses on the inside of the front cover (37 x 28 mm hole pattern; the board holes are 2.5 mm, so the screws locate loosely).
  - No bearings are used. Opposite-horn bearing supports are not designed (see `cad/README.md`, known gap 8).
- Battery: 3S 2200 mAh (assumed 105 x 35 x 25 mm) sits between two printed ribs in the rear bay and is held by 2 hook-and-loop straps through the floor slots. 2.5 x 100 mm cable ties (about 30) go through the tie slots in the thigh, shin and torso side walls.
- E-stop: 16 mm panel-mount unibody mushroom button (IDEC X6/XA outline, 30 mm head) in the 16.2 mm top plate hole (the key notch stops it turning). XT60 panel-mount connector (about $1.20) in the battery door cutout (15.8 x 8.2 mm). Both are envelopes in the model.
- XIAO ESP32-S3 snaps between the rails on the inside of the front cover (it has no mounting holes, so this is a friction fit; add a dab of hot glue if it rattles).
- Electronics are modeled as real vendor CAD (Pi 5, BNO085 IMU, MAX98357 amp, speaker) or as clearly marked size envelopes (camera, XIAO, buck converter, battery, bus adapters, mic, e-stop); see `cad/README.md`.

## 4. Assembly order

1. Fit-test, then print all parts.
2. Fit servos in sleeves (screws into the case holes), horn plate on each horn.
3. Press the 8 M2 heat-set inserts into the torso bosses (soldering iron, 220 C for PLA). Mount the Pi on its standoffs, the battery between the ribs, then close the battery door and the front cover.
4. Build each leg from the foot up (foot, ankle link, shin, thigh, hip roll link, hip yaw link), arms from the hand down, then the torso (it includes the pelvis) and the head (it includes the neck bracket).
5. Run servo ID setup (`sim/joint_map.csv` has the ID, name, direction and limit for each joint) **before** closing the sleeves, since servos must be daisy-chained with IDs 1 to 19.
5. Zero pose: all servos at their mid position (2048 counts) is the URDF/MJCF zero pose. Mount horns at that position.

## 5. Safe joint ranges

The ranges in `sim/joint_map.csv` come from a collision sweep of the final geometry (one joint at a time, others at zero). Combined motions are not checked. Hip yaw and roll are intentionally narrow (the legs are close together), and the arms cannot cross the torso.
