wjb000/budget-humanoid/sim/budget19.urdf

<?xml version="1.0"?>
<!-- Budget-19 humanoid. Generated by cad/sim_export.py. Units: m, kg, rad. Link frames are world-aligned at zero pose, origin at the joint shaft. -->
<robot name="budget19">
  <material name="printed"><color rgba="0.78 0.80 0.84 1"/></material>
  <material name="servo"><color rgba="0.17 0.18 0.21 1"/></material>
  <link name="base">
    <inertial><origin xyz="-0.0252444 0.00404039 0.418896" rpy="0 0 0"/><mass value="0.982852"/>
      <inertia ixx="0.00483797" ixy="-1.70004e-05" ixz="-0.000154384" iyy="0.00362709" iyz="-8.59185e-05" izz="0.00199682"/></inertial>
    <visual><origin xyz="0 0 0" rpy="0 0 0"/><geometry><mesh filename="meshes/base.obj"/></geometry><material name="printed"/></visual>
    <visual name="r_hip_yaw_servo"><origin xyz="-0.04 -0.0425 0.3357" rpy="3.14159 0 -1.5708"/><geometry><mesh filename="meshes/sts3215.obj"/></geometry><material name="servo"/></visual>
    <visual name="l_hip_yaw_servo"><origin xyz="-0.04 0.0425 0.3357" rpy="3.14159 0 1.5708"/><geometry><mesh filename="meshes/sts3215.obj"/></geometry><material name="servo"/></visual>
    <visual name="r_shoulder_pitch_servo"><origin xyz="-0.0224 -0.0748 0.4525" rpy="1.5708 1.5708 0"/><geometry><mesh filename="meshes/sts3215.obj"/></geometry><material name="servo"/></visual>
    <visual name="l_shoulder_pitch_servo"><origin xyz="-0.0224 0.0748 0.4525" rpy="-1.5708 1.5708 0"/><geometry><mesh filename="meshes/sts3215.obj"/></geometry><material name="servo"/></visual>
    <visual name="neck_yaw_servo"><origin xyz="-0.0275 0 0.5228" rpy="0 0 -3.14159"/><geometry><mesh filename="meshes/sts3215.obj"/></geometry><material name="servo"/></visual>
    <visual name="env_Raspberry_Pi_5"><origin xyz="-0.0457877 -0.0181767 0.416498"/><geometry><box size="0.0183011 0.0573984 0.0879215"/></geometry><material name="m_compute"><color rgba="0.12 0.44 0.88 1"/></material></visual>
    <visual name="env_3S_LiPo_2200_mAh_typical_outline"><origin xyz="-0.02 0.026 0.4215"/><geometry><box size="0.025 0.035 0.117"/></geometry><material name="m_power"><color rgba="0.91 0.44 0.04 1"/></material></visual>
    <visual name="env_Pololu_D24V50F5_5_V_buck"><origin xyz="0.0108 0.035 0.385"/><geometry><box size="0.0088 0.0203 0.0178"/></geometry><material name="m_power"><color rgba="0.91 0.44 0.04 1"/></material></visual>
    <visual name="env_Waveshare_bus_adapter_A_legs"><origin xyz="0.0054 -0.031 0.42275"/><geometry><box size="0.0126 0.033 0.0445"/></geometry><material name="m_compute"><color rgba="0.12 0.44 0.88 1"/></material></visual>
    <visual name="env_Waveshare_bus_adapter_B_arms_neck"><origin xyz="0.0054 -0.031 0.46475"/><geometry><box size="0.0126 0.033 0.0445"/></geometry><material name="m_compute"><color rgba="0.12 0.44 0.88 1"/></material></visual>
    <visual name="env_Seeed_XIAO_ESP32-S3"><origin xyz="0.01165 0.025 0.431"/><geometry><box size="0.0042 0.0178 0.0225"/></geometry><material name="m_compute"><color rgba="0.12 0.44 0.88 1"/></material></visual>
    <visual name="env_Relay_+_fuse_holder"><origin xyz="-0.025 -0.032 0.378"/><geometry><box size="0.02 0.02 0.03"/></geometry><material name="m_power"><color rgba="0.91 0.44 0.04 1"/></material></visual>
    <visual name="env_Adafruit_BNO085_IMU"><origin xyz="-0.01 -0.00462166 0.363884"/><geometry><box size="0.0254 0.0221033 0.00276795"/></geometry><material name="m_sensor"><color rgba="0.1 0.6 0.33 1"/></material></visual>
    <visual name="env_40_mm_speaker"><origin xyz="0.00266165 -0.012772 0.388053"/><geometry><box size="0.0250343 0.0397942 0.0399567"/></geometry><material name="m_sensor"><color rgba="0.1 0.6 0.33 1"/></material></visual>
    <visual name="env_MAX98357A_I2S_amp"><origin xyz="0.013774 -0.00250923 0.41999"/><geometry><box size="0.00234808 0.0174158 0.01778"/></geometry><material name="m_sensor"><color rgba="0.1 0.6 0.33 1"/></material></visual>
    <visual name="env_E-stop_16_mm_unibody,_NC,_latching"><origin xyz="-0.03 0.036 0.49855"/><geometry><box size="0.03 0.0299161 0.0441"/></geometry><material name="m_power"><color rgba="0.91 0.44 0.04 1"/></material></visual>
    <visual name="env_XT60_panel_connector_charge_port"><origin xyz="-0.0558 0.026 0.482"/><geometry><box size="0.018 0.016 0.0081"/></geometry><material name="m_power"><color rgba="0.91 0.44 0.04 1"/></material></visual>
  </link>
  <link name="r_foot">
    <inertial><origin xyz="-0.00793475 9.90203e-09 -0.0163007" rpy="0 0 0"/><mass value="0.0354951"/>
      <inertia ixx="1.26238e-05" ixy="3.61196e-11" ixz="-1.07029e-06" iyy="4.89843e-05" iyz="1.65015e-11" izz="5.01619e-05"/></inertial>
    <visual><origin xyz="0 0 0" rpy="0 0 0"/><geometry><mesh filename="meshes/r_foot.obj"/></geometry><material name="printed"/></visual>
    <collision><origin xyz="-0.011 0 -0.023"/><geometry><box size="0.122 0.056 0.004"/></geometry></collision>
  </link>
  <link name="r_ankle_link">
    <inertial><origin xyz="0.00191297 0.0144518 -0.0374398" rpy="0 0 0"/><mass value="0.0769925"/>
      <inertia ixx="3.14209e-05" ixy="-1.1018e-07" ixz="6.09626e-07" iyy="3.46897e-05" iyz="2.84812e-06" izz="1.39515e-05"/></inertial>
    <visual><origin xyz="0 0 0" rpy="0 0 0"/><geometry><mesh filename="meshes/r_ankle_link.obj"/></geometry><material name="printed"/></visual>
    <visual name="r_ankle_roll_servo"><origin xyz="0.0033 0.0152 -0.0405" rpy="-0 1.5708 0"/><geometry><mesh filename="meshes/sts3215.obj"/></geometry><material name="servo"/></visual>
  </link>
  <link name="r_shin">
    <inertial><origin xyz="8.29409e-08 0.0135404 -0.0760556" rpy="0 0 0"/><mass value="0.0870581"/>
      <inertia ixx="7.97093e-05" ixy="-1.90935e-11" ixz="-2.70447e-10" iyy="7.01483e-05" iyz="1.26417e-05" izz="2.09551e-05"/></inertial>
    <visual><origin xyz="0 0 0" rpy="0 0 0"/><geometry><mesh filename="meshes/r_shin.obj"/></geometry><material name="printed"/></visual>
    <visual name="r_ankle_pitch_servo"><origin xyz="0 0.0187 -0.0845" rpy="-1.5708 1.5708 0"/><geometry><mesh filename="meshes/sts3215.obj"/></geometry><material name="servo"/></visual>
  </link>
  <link name="r_thigh">
    <inertial><origin xyz="-8.7768e-08 -0.0203383 -0.0820283" rpy="0 0 0"/><mass value="0.101656"/>
      <inertia ixx="6.13843e-05" ixy="-2.1406e-11" ixz="3.36427e-11" iyy="5.49293e-05" iyz="-8.77145e-06" izz="1.90142e-05"/></inertial>
    <visual><origin xyz="0 0 0" rpy="0 0 0"/><geometry><mesh filename="meshes/r_thigh.obj"/></geometry><material name="printed"/></visual>
    <visual name="r_knee_servo"><origin xyz="0 -0.0229 -0.0875" rpy="1.5708 1.5708 0"/><geometry><mesh filename="meshes/sts3215.obj"/></geometry><material name="servo"/></visual>
  </link>
  <link name="r_hip_roll_link">
    <inertial><origin xyz="0.0274745 0.00833604 -0.0122249" rpy="0 0 0"/><mass value="0.0952103"/>
      <inertia ixx="2.80195e-05" ixy="-6.80095e-07" ixz="8.12502e-07" iyy="2.46916e-05" iyz="5.78749e-07" izz="1.75482e-05"/></inertial>
    <visual><origin xyz="0 0 0" rpy="0 0 0"/><geometry><mesh filename="meshes/r_hip_roll_link.obj"/></geometry><material name="printed"/></visual>
    <visual name="r_hip_pitch_servo"><origin xyz="0.0282 0.0077 -0.0125" rpy="1.5708 -1.5708 0"/><geometry><mesh filename="meshes/sts3215.obj"/></geometry><material name="servo"/></visual>
  </link>
  <link name="r_hip_yaw_link">
    <inertial><origin xyz="-0.00769975 0.000694954 -0.027868" rpy="0 0 0"/><mass value="0.0770069"/>
      <inertia ixx="2.30142e-05" ixy="-4.12113e-07" ixz="-7.65584e-07" iyy="2.56238e-05" iyz="-1.3793e-06" izz="1.51578e-05"/></inertial>
    <visual><origin xyz="0 0 0" rpy="0 0 0"/><geometry><mesh filename="meshes/r_hip_yaw_link.obj"/></geometry><material name="printed"/></visual>
    <visual name="r_hip_roll_servo"><origin xyz="-0.0069 0 -0.0295" rpy="-0 1.5708 0"/><geometry><mesh filename="meshes/sts3215.obj"/></geometry><material name="servo"/></visual>
  </link>
  <link name="r_upper_arm">
    <inertial><origin xyz="0.033996 -0.0165551 -0.0616951" rpy="0 0 0"/><mass value="0.0902916"/>
      <inertia ixx="6.19496e-05" ixy="2.09106e-06" ixz="1.56339e-05" iyy="6.62875e-05" iyz="-5.12834e-06" izz="2.63526e-05"/></inertial>
    <visual><origin xyz="0 0 0" rpy="0 0 0"/><geometry><mesh filename="meshes/r_upper_arm.obj"/></geometry><material name="printed"/></visual>
    <visual name="r_elbow_servo"><origin xyz="0.0389 -0.0159 -0.0685" rpy="-1.5708 1.5708 0"/><geometry><mesh filename="meshes/sts3215.obj"/></geometry><material name="servo"/></visual>
  </link>
  <link name="r_forearm">
    <inertial><origin xyz="0.00203198 -0.01579 -0.0664544" rpy="0 0 0"/><mass value="0.0887601"/>
      <inertia ixx="7.38015e-05" ixy="-1.60495e-07" ixz="7.25662e-06" iyy="7.0135e-05" iyz="-6.83323e-06" izz="1.96379e-05"/></inertial>
    <visual><origin xyz="0 0 0" rpy="0 0 0"/><geometry><mesh filename="meshes/r_forearm.obj"/></geometry><material name="printed"/></visual>
    <visual name="r_gripper_servo"><origin xyz="0 -0.0187 -0.0665" rpy="1.5708 -1.5708 0"/><geometry><mesh filename="meshes/sts3215.obj"/></geometry><material name="servo"/></visual>
  </link>
  <link name="r_finger">
    <inertial><origin xyz="-0.00110979 0.00334888 -0.0408828" rpy="0 0 0"/><mass value="0.00946515"/>
      <inertia ixx="7.4122e-06" ixy="-5.78359e-09" ixz="-1.91359e-07" iyy="7.17511e-06" iyz="1.23719e-06" izz="1.06221e-06"/></inertial>
    <visual><origin xyz="0 0 0" rpy="0 0 0"/><geometry><mesh filename="meshes/r_finger.obj"/></geometry><material name="printed"/></visual>
  </link>
  <link name="l_foot">
    <inertial><origin xyz="-0.00793475 -9.90203e-09 -0.0163007" rpy="0 0 0"/><mass value="0.0354951"/>
      <inertia ixx="1.26238e-05" ixy="-3.61196e-11" ixz="-1.07029e-06" iyy="4.89843e-05" iyz="-1.65015e-11" izz="5.01619e-05"/></inertial>
    <visual><origin xyz="0 0 0" rpy="0 0 0"/><geometry><mesh filename="meshes/l_foot.obj"/></geometry><material name="printed"/></visual>
    <collision><origin xyz="-0.011 0 -0.023"/><geometry><box size="0.122 0.056 0.004"/></geometry></collision>
  </link>
  <link name="l_ankle_link">
    <inertial><origin xyz="0.00191297 -0.014452 -0.0374398" rpy="0 0 0"/><mass value="0.0769925"/>
      <inertia ixx="3.14209e-05" ixy="1.10193e-07" ixz="6.09626e-07" iyy="3.46897e-05" iyz="-2.84796e-06" izz="1.39515e-05"/></inertial>
    <visual><origin xyz="0 0 0" rpy="0 0 0"/><geometry><mesh filename="meshes/l_ankle_link.obj"/></geometry><material name="printed"/></visual>
    <visual name="l_ankle_roll_servo"><origin xyz="0.0033 -0.0152 -0.0405" rpy="-0 1.5708 0"/><geometry><mesh filename="meshes/sts3215.obj"/></geometry><material name="servo"/></visual>
  </link>
  <link name="l_shin">
    <inertial><origin xyz="-7.91865e-08 -0.0135404 -0.0760556" rpy="0 0 0"/><mass value="0.0870581"/>
      <inertia ixx="7.97093e-05" ixy="-4.68935e-11" ixz="-1.87975e-10" iyy="7.01483e-05" iyz="-1.26417e-05" izz="2.09551e-05"/></inertial>
    <visual><origin xyz="0 0 0" rpy="0 0 0"/><geometry><mesh filename="meshes/l_shin.obj"/></geometry><material name="printed"/></visual>
    <visual name="l_ankle_pitch_servo"><origin xyz="0 -0.0187 -0.0845" rpy="1.5708 1.5708 0"/><geometry><mesh filename="meshes/sts3215.obj"/></geometry><material name="servo"/></visual>
  </link>
  <link name="l_thigh">
    <inertial><origin xyz="9.69675e-08 0.0203383 -0.0820283" rpy="0 0 0"/><mass value="0.101656"/>
      <inertia ixx="6.13843e-05" ixy="-1.76035e-11" ixz="-1.31912e-10" iyy="5.49293e-05" iyz="8.77145e-06" izz="1.90142e-05"/></inertial>
    <visual><origin xyz="0 0 0" rpy="0 0 0"/><geometry><mesh filename="meshes/l_thigh.obj"/></geometry><material name="printed"/></visual>
    <visual name="l_knee_servo"><origin xyz="0 0.0229 -0.0875" rpy="-1.5708 1.5708 0"/><geometry><mesh filename="meshes/sts3215.obj"/></geometry><material name="servo"/></visual>
  </link>
  <link name="l_hip_roll_link">
    <inertial><origin xyz="0.0274743 -0.00833604 -0.0122249" rpy="0 0 0"/><mass value="0.0952103"/>
      <inertia ixx="2.80195e-05" ixy="6.80097e-07" ixz="8.12231e-07" iyy="2.46915e-05" iyz="-5.78747e-07" izz="1.75482e-05"/></inertial>
    <visual><origin xyz="0 0 0" rpy="0 0 0"/><geometry><mesh filename="meshes/l_hip_roll_link.obj"/></geometry><material name="printed"/></visual>
    <visual name="l_hip_pitch_servo"><origin xyz="0.0282 -0.0077 -0.0125" rpy="-1.5708 -1.5708 0"/><geometry><mesh filename="meshes/sts3215.obj"/></geometry><material name="servo"/></visual>
  </link>
  <link name="l_hip_yaw_link">
    <inertial><origin xyz="-0.00769975 -0.000695137 -0.027868" rpy="0 0 0"/><mass value="0.0770069"/>
      <inertia ixx="2.30142e-05" ixy="4.12118e-07" ixz="-7.65584e-07" iyy="2.56238e-05" iyz="1.37948e-06" izz="1.51578e-05"/></inertial>
    <visual><origin xyz="0 0 0" rpy="0 0 0"/><geometry><mesh filename="meshes/l_hip_yaw_link.obj"/></geometry><material name="printed"/></visual>
    <visual name="l_hip_roll_servo"><origin xyz="-0.0069 0 -0.0295" rpy="-0 1.5708 0"/><geometry><mesh filename="meshes/sts3215.obj"/></geometry><material name="servo"/></visual>
  </link>
  <link name="l_upper_arm">
    <inertial><origin xyz="0.0339958 0.0165551 -0.0616951" rpy="0 0 0"/><mass value="0.0902916"/>
      <inertia ixx="6.19495e-05" ixy="-2.09107e-06" ixz="1.5634e-05" iyy="6.62873e-05" iyz="5.12834e-06" izz="2.63525e-05"/></inertial>
    <visual><origin xyz="0 0 0" rpy="0 0 0"/><geometry><mesh filename="meshes/l_upper_arm.obj"/></geometry><material name="printed"/></visual>
    <visual name="l_elbow_servo"><origin xyz="0.0389 0.0159 -0.0685" rpy="1.5708 1.5708 0"/><geometry><mesh filename="meshes/sts3215.obj"/></geometry><material name="servo"/></visual>
  </link>
  <link name="l_forearm">
    <inertial><origin xyz="0.00203182 0.01579 -0.0664544" rpy="0 0 0"/><mass value="0.0887601"/>
      <inertia ixx="7.38015e-05" ixy="1.60529e-07" ixz="7.25641e-06" iyy="7.01351e-05" iyz="6.83324e-06" izz="1.96379e-05"/></inertial>
    <visual><origin xyz="0 0 0" rpy="0 0 0"/><geometry><mesh filename="meshes/l_forearm.obj"/></geometry><material name="printed"/></visual>
    <visual name="l_gripper_servo"><origin xyz="0 0.0187 -0.0665" rpy="-1.5708 -1.5708 0"/><geometry><mesh filename="meshes/sts3215.obj"/></geometry><material name="servo"/></visual>
  </link>
  <link name="l_finger">
    <inertial><origin xyz="-0.00110979 -0.00334888 -0.0408828" rpy="0 0 0"/><mass value="0.00946516"/>
      <inertia ixx="7.4122e-06" ixy="5.78357e-09" ixz="-1.91359e-07" iyy="7.17511e-06" iyz="-1.23719e-06" izz="1.06221e-06"/></inertial>
    <visual><origin xyz="0 0 0" rpy="0 0 0"/><geometry><mesh filename="meshes/l_finger.obj"/></geometry><material name="printed"/></visual>
  </link>
  <link name="head">
    <inertial><origin xyz="0.0127807 0.000229491 0.0328617" rpy="0 0 0"/><mass value="0.0592613"/>
      <inertia ixx="3.62484e-05" ixy="-1.66181e-07" ixz="3.57758e-07" iyy="4.16136e-05" iyz="3.89202e-08" izz="2.19961e-05"/></inertial>
    <visual><origin xyz="0 0 0" rpy="0 0 0"/><geometry><mesh filename="meshes/head.obj"/></geometry><material name="printed"/></visual>
    <visual name="env_Pi_Camera_Module_3"><origin xyz="0.026 0 0.03785"/><geometry><box size="0.0115 0.025 0.0245"/></geometry><material name="m_sensor"><color rgba="0.1 0.6 0.33 1"/></material></visual>
    <visual name="env_I2S_MEMS_mic"><origin xyz="0.025 0.0136 0.03"/><geometry><box size="0.0127 0.0016 0.008"/></geometry><material name="m_sensor"><color rgba="0.1 0.6 0.33 1"/></material></visual>
  </link>
  <link name="imu_link"/>
  <joint name="imu_joint" type="fixed"><parent link="base"/><child link="imu_link"/><origin xyz="-0.01 -0.005 0.3648"/></joint>
  <link name="head_camera_link"/>
  <joint name="head_camera_joint" type="fixed"><parent link="head"/><child link="head_camera_link"/><origin xyz="0.031 0 0.045"/></joint>
  <joint name="r_hip_yaw" type="revolute"><!-- servo ID 1 -->
    <parent link="base"/><child link="r_hip_yaw_link"/><origin xyz="-0.04 -0.055 0.317" rpy="0 0 0"/><axis xyz="0 0 -1"/>
    <limit lower="-0.56" upper="0.28" effort="2.94" velocity="4.72"/><dynamics damping="0.05" friction="0.03"/></joint>
  <joint name="r_hip_roll" type="revolute"><!-- servo ID 2 -->
    <parent link="r_hip_yaw_link"/><child link="r_hip_roll_link"/><origin xyz="0.0118 0 -0.042" rpy="0 0 0"/><axis xyz="1 0 0"/>
    <limit lower="-0.24" upper="0.2" effort="2.94" velocity="4.72"/><dynamics damping="0.05" friction="0.03"/></joint>
  <joint name="r_hip_pitch" type="revolute"><!-- servo ID 3 -->
    <parent link="r_hip_roll_link"/><child link="r_thigh"/><origin xyz="0.0282 -0.011 0" rpy="0 0 0"/><axis xyz="0 -1 0"/>
    <limit lower="-0.6" upper="0.95" effort="4.9" velocity="7.87"/><dynamics damping="0.05" friction="0.03"/></joint>
  <joint name="r_knee" type="revolute"><!-- servo ID 4 -->
    <parent link="r_thigh"/><child link="r_shin"/><origin xyz="0 -0.0416 -0.1" rpy="0 0 0"/><axis xyz="0 -1 0"/>
    <limit lower="-1.9" upper="0.09" effort="4.9" velocity="7.87"/><dynamics damping="0.05" friction="0.03"/></joint>
  <joint name="r_ankle_pitch" type="revolute"><!-- servo ID 5 -->
    <parent link="r_shin"/><child link="r_ankle_link"/><origin xyz="0 0.0374 -0.097" rpy="0 0 0"/><axis xyz="0 1 0"/>
    <limit lower="-0.76" upper="0.76" effort="2.94" velocity="4.72"/><dynamics damping="0.05" friction="0.03"/></joint>
  <joint name="r_ankle_roll" type="revolute"><!-- servo ID 6 -->
    <parent link="r_ankle_link"/><child link="r_foot"/><origin xyz="0.022 0.0152 -0.053" rpy="0 0 0"/><axis xyz="1 0 0"/>
    <limit lower="-0.33" upper="0.33" effort="2.94" velocity="4.72"/><dynamics damping="0.05" friction="0.03"/></joint>
  <joint name="r_shoulder_pitch" type="revolute"><!-- servo ID 13 -->
    <parent link="base"/><child link="r_upper_arm"/><origin xyz="-0.0224 -0.0935 0.44" rpy="0 0 0"/><axis xyz="0 -1 0"/>
    <limit lower="-1.9" upper="1.9" effort="2.94" velocity="4.72"/><dynamics damping="0.05" friction="0.03"/></joint>
  <joint name="r_elbow" type="revolute"><!-- servo ID 14 -->
    <parent link="r_upper_arm"/><child link="r_forearm"/><origin xyz="0.0389 0.0028 -0.081" rpy="0 0 0"/><axis xyz="0 1 0"/>
    <limit lower="-1.42" upper="1.42" effort="2.94" velocity="4.72"/><dynamics damping="0.05" friction="0.03"/></joint>
  <joint name="r_gripper" type="revolute"><!-- servo ID 15 -->
    <parent link="r_forearm"/><child link="r_finger"/><origin xyz="0 -0.0374 -0.054" rpy="0 0 0"/><axis xyz="0 -1 0"/>
    <limit lower="-0.47" upper="0.11" effort="2.94" velocity="4.72"/><dynamics damping="0.05" friction="0.03"/></joint>
  <joint name="l_hip_yaw" type="revolute"><!-- servo ID 7 -->
    <parent link="base"/><child link="l_hip_yaw_link"/><origin xyz="-0.04 0.055 0.317" rpy="0 0 0"/><axis xyz="0 0 -1"/>
    <limit lower="-0.28" upper="0.56" effort="2.94" velocity="4.72"/><dynamics damping="0.05" friction="0.03"/></joint>
  <joint name="l_hip_roll" type="revolute"><!-- servo ID 8 -->
    <parent link="l_hip_yaw_link"/><child link="l_hip_roll_link"/><origin xyz="0.0118 0 -0.042" rpy="0 0 0"/><axis xyz="1 0 0"/>
    <limit lower="-0.2" upper="0.24" effort="2.94" velocity="4.72"/><dynamics damping="0.05" friction="0.03"/></joint>
  <joint name="l_hip_pitch" type="revolute"><!-- servo ID 9 -->
    <parent link="l_hip_roll_link"/><child link="l_thigh"/><origin xyz="0.0282 0.011 0" rpy="0 0 0"/><axis xyz="0 1 0"/>
    <limit lower="-0.95" upper="0.6" effort="4.9" velocity="7.87"/><dynamics damping="0.05" friction="0.03"/></joint>
  <joint name="l_knee" type="revolute"><!-- servo ID 10 -->
    <parent link="l_thigh"/><child link="l_shin"/><origin xyz="0 0.0416 -0.1" rpy="0 0 0"/><axis xyz="0 1 0"/>
    <limit lower="-0.09" upper="1.9" effort="4.9" velocity="7.87"/><dynamics damping="0.05" friction="0.03"/></joint>
  <joint name="l_ankle_pitch" type="revolute"><!-- servo ID 11 -->
    <parent link="l_shin"/><child link="l_ankle_link"/><origin xyz="0 -0.0374 -0.097" rpy="0 0 0"/><axis xyz="0 -1 0"/>
    <limit lower="-0.76" upper="0.76" effort="2.94" velocity="4.72"/><dynamics damping="0.05" friction="0.03"/></joint>
  <joint name="l_ankle_roll" type="revolute"><!-- servo ID 12 -->
    <parent link="l_ankle_link"/><child link="l_foot"/><origin xyz="0.022 -0.0152 -0.053" rpy="0 0 0"/><axis xyz="1 0 0"/>
    <limit lower="-0.33" upper="0.33" effort="2.94" velocity="4.72"/><dynamics damping="0.05" friction="0.03"/></joint>
  <joint name="l_shoulder_pitch" type="revolute"><!-- servo ID 16 -->
    <parent link="base"/><child link="l_upper_arm"/><origin xyz="-0.0224 0.0935 0.44" rpy="0 0 0"/><axis xyz="0 1 0"/>
    <limit lower="-1.9" upper="1.9" effort="2.94" velocity="4.72"/><dynamics damping="0.05" friction="0.03"/></joint>
  <joint name="l_elbow" type="revolute"><!-- servo ID 17 -->
    <parent link="l_upper_arm"/><child link="l_forearm"/><origin xyz="0.0389 -0.0028 -0.081" rpy="0 0 0"/><axis xyz="0 -1 0"/>
    <limit lower="-1.42" upper="1.42" effort="2.94" velocity="4.72"/><dynamics damping="0.05" friction="0.03"/></joint>
  <joint name="l_gripper" type="revolute"><!-- servo ID 18 -->
    <parent link="l_forearm"/><child link="l_finger"/><origin xyz="0 0.0374 -0.054" rpy="0 0 0"/><axis xyz="0 1 0"/>
    <limit lower="-0.11" upper="0.47" effort="2.94" velocity="4.72"/><dynamics damping="0.05" friction="0.03"/></joint>
  <joint name="neck_yaw" type="revolute"><!-- servo ID 19 -->
    <parent link="base"/><child link="head"/><origin xyz="-0.04 0 0.5415" rpy="0 0 0"/><axis xyz="0 0 1"/>
    <limit lower="-1.13" upper="1.13" effort="2.94" velocity="4.72"/><dynamics damping="0.05" friction="0.03"/></joint>
</robot>
