wjb000/budget-humanoid/(commit log)

2026-11-10 Site assets: BOM data, 3D viewer, robot image
2026-11-10 Phase 1 landing page and README
2026-11-10 cad: README, print guide, root README, gitignore
2026-11-10 cad: parametric CadQuery sources (lib, robot, assembly)
2026-11-10 cad: collision tools, export
    [collider.py, export.py, sweep.py, tune.py]
2026-11-10 cad: sim export, vendor scripts, fit coupon, print-guide generator
2026-11-10 cad: generators, limits and reports
2026-11-10 cad/vendor: STS3215 STEP (Apache-2.0) + licenses
2026-11-10 cad/vendor: Adafruit BNO085, MAX98357, speaker STEP (MIT)
2026-11-10 sim: MuJoCo MJCF, URDF, joint map, check script, README (Isaac Lab notes)
    [budget22.urdf]
2026-11-10 sim: joint map, mass properties, base + servo meshes
    [base.obj, joint_map.csv, sts3215.obj]
2026-11-10 sim: link meshes 1/6
    [head.obj, l_ankle_link.obj, l_foot.obj, neck_bracket.obj]
2026-11-10 sim: link meshes 2/6
    [l_hip_roll_link.obj, l_hip_yaw_link.obj, l_shin.obj, l_thigh.obj]
2026-11-10 sim: link meshes 3/6
    [l_finger.obj, l_forearm.obj, l_shoulder_link.obj, l_upper_arm.obj]
2026-11-10 sim: link meshes 4/6
    [r_ankle_link.obj, r_foot.obj, r_shin.obj, r_thigh.obj]
2026-11-10 sim: link meshes 5/6
    [r_hip_roll_link.obj, r_hip_yaw_link.obj, r_shoulder_link.obj, r_upper_arm.obj]
2026-11-10 sim: link meshes 6/6
    [r_finger.obj, r_forearm.obj]
2026-11-10 cad: STL+STEP head, pelvis
    [head.step, head.stl, pelvis.step, pelvis.stl]
2026-11-10 cad: STL+STEP torso, neck_bracket
    [neck_bracket.step, neck_bracket.stl, torso.step, torso.stl]
2026-11-10 cad: STL+STEP l_foot, l_ankle_link
    [l_ankle_link.step, l_ankle_link.stl, l_foot.step, l_foot.stl]
2026-11-10 cad: STL+STEP l_shin, l_thigh
    [l_shin.step, l_shin.stl, l_thigh.step, l_thigh.stl]
2026-11-10 cad: STL+STEP l_hip_roll_link, l_hip_yaw_link
    [l_hip_roll_link.step, l_hip_roll_link.stl, l_hip_yaw_link.step, l_hip_yaw_link.stl]
2026-11-10 cad: STL+STEP l_shoulder_link, l_upper_arm
    [l_shoulder_link.step, l_shoulder_link.stl, l_upper_arm.step, l_upper_arm.stl]
2026-11-10 cad: STL+STEP l_forearm, l_finger
    [l_finger.step, l_finger.stl, l_forearm.step, l_forearm.stl]
2026-11-10 cad: STL+STEP r_foot, r_ankle_link
    [r_ankle_link.step, r_ankle_link.stl, r_foot.step, r_foot.stl]
2026-11-10 cad: STL+STEP r_shin, r_thigh
    [r_shin.step, r_shin.stl, r_thigh.step, r_thigh.stl]
2026-11-10 cad: STL+STEP r_hip_roll_link, r_hip_yaw_link
    [r_hip_roll_link.step, r_hip_roll_link.stl, r_hip_yaw_link.step, r_hip_yaw_link.stl]
2026-11-10 cad: STL+STEP r_shoulder_link, r_upper_arm
    [r_shoulder_link.step, r_shoulder_link.stl, r_upper_arm.step, r_upper_arm.stl]
2026-11-10 cad: STL+STEP r_forearm, r_finger
    [r_finger.step, r_finger.stl, r_forearm.step, r_forearm.stl]
2026-11-10 cad: fit coupons (STL+STEP)
    [fit_coupon_plate.step, fit_coupon_plate.stl, fit_coupon_sleeve.step, fit_coupon_sleeve.stl]
2026-11-10 site: CAD assembly viewer (glTF), CAD status + downloads section
2026-11-10 Docs: DFM injection-molding notes, M2/M3 hardware list, known gaps, print guide
2026-11-10 CAD: torso front cover, battery door, head lid; Pi standoffs, battery bay, e-stop key, tie slots; M2/M3 only
2026-11-10 CAD pipeline: assembly cover hosts, electronics layout, compact STL writer, BOM generator
2026-11-10 CAD data: limits, print report, joints, overlaps; BOM generator with M2/M3, inserts, XT60
2026-11-10 STL: battery door, head, fit coupons (compact ASCII)
    [battery_door.stl, fit_coupon_plate.stl, fit_coupon_sleeve.stl, head.stl]
2026-11-10 STL: head lid, left ankle, finger, foot
    [head_lid.stl, l_ankle_link.stl, l_finger.stl, l_foot.stl]
2026-11-10 STL: left forearm, hip roll, hip yaw, shin
    [l_forearm.stl, l_hip_roll_link.stl, l_hip_yaw_link.stl, l_shin.stl]
2026-11-10 STL: left shoulder, thigh, upper arm, neck bracket
    [l_shoulder_link.stl, l_thigh.stl, l_upper_arm.stl, neck_bracket.stl]
2026-11-10 STL: pelvis, right ankle, finger, foot
    [pelvis.stl, r_ankle_link.stl, r_finger.stl, r_foot.stl]
2026-11-10 STL: right forearm, hip roll, hip yaw, shin
    [r_forearm.stl, r_hip_roll_link.stl, r_hip_yaw_link.stl, r_shin.stl]
2026-11-10 STL: torso, right shoulder, thigh, upper arm
    [r_shoulder_link.stl, r_thigh.stl, r_upper_arm.stl, torso.stl]
2026-11-10 CAD: torso front cover STL; STEP battery door, head, head lid
    [battery_door.step, head.step, head_lid.step, torso_front_cover.stl]
2026-11-10 STEP: left ankle, finger, foot, forearm
    [l_ankle_link.step, l_finger.step, l_foot.step, l_forearm.step]
2026-11-10 STEP: left hip roll, hip yaw, shin, shoulder
    [l_hip_roll_link.step, l_hip_yaw_link.step, l_shin.step, l_shoulder_link.step]
2026-11-10 STEP: left thigh, upper arm, neck bracket, pelvis
    [l_thigh.step, l_upper_arm.step, neck_bracket.step, pelvis.step]
2026-11-10 STEP: right ankle, finger, foot, forearm
    [r_ankle_link.step, r_finger.step, r_foot.step, r_forearm.step]
2026-11-10 STEP: right hip roll, hip yaw, shin, shoulder
    [r_hip_roll_link.step, r_hip_yaw_link.step, r_shin.step, r_shoulder_link.step]
2026-11-10 STEP: right thigh, upper arm, torso, front cover
    [r_thigh.step, r_upper_arm.step, torso.step, torso_front_cover.step]
2026-11-10 sim meshes: base (with covers), head (with lid), left ankle, finger
    [base.obj, head.obj, l_ankle_link.obj, l_finger.obj]
2026-11-10 sim meshes: left foot, forearm, hip roll, hip yaw
    [l_foot.obj, l_forearm.obj, l_hip_roll_link.obj, l_hip_yaw_link.obj]
2026-11-10 sim meshes: left shin, shoulder, thigh, upper arm
    [l_shin.obj, l_shoulder_link.obj, l_thigh.obj, l_upper_arm.obj]
2026-11-10 sim meshes: neck bracket, right ankle, finger, foot
    [neck_bracket.obj, r_ankle_link.obj, r_finger.obj, r_foot.obj]
2026-11-10 sim meshes: right forearm, hip roll, hip yaw, shin
    [r_forearm.obj, r_hip_roll_link.obj, r_hip_yaw_link.obj, r_shin.obj]
2026-11-10 sim meshes: right shoulder, thigh, upper arm, servo
    [r_shoulder_link.obj, r_thigh.obj, r_upper_arm.obj]
2026-11-10 sim: URDF + MJCF regenerated with covers; mass props; README (MuJoCo stand check PASS)
    [budget22.urdf]
2026-11-10 site: assembled-robot viewer (covers, role colours, visible e-stop and charge port), new glTF, BOM data
2026-11-10 site: status text, covers toggle, DFM link, BOM total, known gaps
    [joint_map.csv]
2026-11-10 Site cleanup: drop AI image/pin map, product plan, recommended tier; component map and layer toggles now live in the 3D viewer
2026-11-10 v2 CAD: servo pods are the brackets, 19 DOF, pelvis/neck/shoulder merged, datasheet-modelled electronics
2026-11-10 v2 pipeline: assembly/export/sim_export for 19 DOF, regenerated limits
2026-11-10 v2 STL 1/6: torso, head, head lid, battery door
    [battery_door.stl, head.stl, head_lid.stl, torso.stl]
2026-11-10 v2 STL 2/6
    [l_foot.stl, r_ankle_link.stl, r_foot.stl, torso_front_cover.stl]
2026-11-10 v2 STL 3/6
    [l_ankle_link.stl, l_shin.stl, r_shin.stl, r_thigh.stl]
2026-11-10 v2 STL 4/6
    [l_hip_roll_link.stl, l_thigh.stl, r_hip_roll_link.stl, r_hip_yaw_link.stl]
2026-11-10 v2 STL 5/6
    [l_hip_yaw_link.stl, l_upper_arm.stl, r_forearm.stl, r_upper_arm.stl]
2026-11-10 v2 STL 6/6
    [l_finger.stl, l_forearm.stl, r_finger.stl]
2026-11-10 v2 STEP 1/6
    [battery_door.step, head.step, head_lid.step, torso.step]
2026-11-10 v2 STEP 2/6
    [l_foot.step, r_ankle_link.step, r_foot.step, torso_front_cover.step]
2026-11-10 v2 STEP 3/6
    [l_ankle_link.step, l_shin.step, r_shin.step, r_thigh.step]
2026-11-10 v2 STEP 4/6
    [l_hip_roll_link.step, l_thigh.step, r_hip_roll_link.step, r_hip_yaw_link.step]
2026-11-10 v2 STEP 5/6
    [l_hip_yaw_link.step, l_upper_arm.step, r_forearm.step, r_upper_arm.step]
2026-11-10 v2 STEP 6/6, print report
    [l_finger.step, l_forearm.step, r_finger.step]
2026-11-10 v2 sim: budget19 URDF + MJCF (19 actuators), joint map, mass properties
    [budget19.urdf, joint_map.csv]
2026-11-10 v2 sim meshes 1/6
    [base.obj, head.obj, r_foot.obj]
2026-11-10 v2 sim meshes 2/6
    [l_ankle_link.obj, l_foot.obj, r_ankle_link.obj, r_shin.obj]
2026-11-10 v2 sim meshes 3/6
    [l_shin.obj, l_thigh.obj, r_hip_roll_link.obj, r_thigh.obj]
2026-11-10 v2 sim meshes 4/6
    [l_hip_roll_link.obj, l_hip_yaw_link.obj, r_hip_yaw_link.obj, r_upper_arm.obj]
2026-11-10 v2 sim meshes 5/6
    [l_forearm.obj, l_upper_arm.obj, r_finger.obj, r_forearm.obj]
2026-11-10 v2 sim meshes 6/6, joints, electronics overlap report, mujoco check
    [l_finger.obj]
2026-11-10 v2 docs: README, CAD README, DFM, print guide
2026-11-10 fix: mirror knee and gripper limits per side (right knee previously flexed forward)
    [joint_map.csv]
2026-11-10 sim: regenerate URDF/MJCF with mirrored knee/gripper limits
    [budget19.urdf]
2026-11-10 sim2real: STS3215 actuator model, Gymnasium/MuJoCo env, shared obs, domain randomization, default pose
2026-11-10 deploy: Pi runtime, ESP32 framing, STS bus driver, ESP32 stand-in, tests
2026-11-10 deploy: ESP32 bridge firmware (uncompiled), tests, README; sim default pose
2026-11-10 single design: STS3250 on hip pitch + knee, STS3215 elsewhere (CAD export, URDF/MJCF per-joint torque limits)
    [budget19.urdf]
2026-11-10 sim: per-joint servo model (joint map columns, mass, actuator + env arrays)
    [joint_map.csv]
2026-11-10 docs: single design, per-joint servo model; default pose; check_mujoco per-servo load
2026-11-10 docs: print guide servo list and IDs, root README, single-BOM generator
2026-11-10 site: one robot, one BOM and total (no tiers), build guide section, reference sections removed
2026-11-10 sim2real: JSON policy export/loading, walk learning curve
    [progress.csv]
2026-11-10 v3 droid look: docs and CAD source (1/24)
2026-11-10 v3 droid look: CAD source (2/24)
2026-11-10 v3 droid look: STEP (3/24)
    [battery_door.step, head.step, head_lid.step]
2026-11-10 v3 droid look: STEP (4/24)
    [l_ankle_link.step, l_finger.step, l_foot.step, l_forearm.step]
2026-11-10 v3 droid look: STEP (5a)
    [l_hip_roll_link.step, l_hip_yaw_link.step]
2026-11-10 v3 droid look: STEP
    [l_shin.step, l_thigh.step]
2026-11-10 v3 droid look: torso STEP
    [torso.step]
2026-11-10 v3 droid look: front cover STEP
    [torso_front_cover.step]
2026-11-10 v3 droid look: STL
    [battery_door.stl, head.stl]
2026-11-10 v3 droid look: torso STL
    [torso.stl]
2026-11-10 v3 droid look: front cover STL
    [torso_front_cover.stl]
2026-11-10 v3 droid look: sim package
    [budget19.urdf]
2026-11-10 v3 droid look: sim data and base mesh
    [base.obj, joint_map.csv]
2026-11-10 v3 droid look: sim meshes
    [head.obj, l_ankle_link.obj, l_finger.obj, l_foot.obj]
2026-11-10 v3 droid look: sim meshes, BOM generator
    [r_shin.obj, r_thigh.obj, r_upper_arm.obj]
2026-11-10 v3 droid look: site (viewer colours, cache-busted model, BOM mass)
2026-11-10 v4 1/37: docs and CAD source
2026-11-10 v4 2/37: CAD source and limits
2026-11-10 v4 4/37: MJCF, joint map, mass properties
    [joint_map.csv]
2026-11-10 v4 3/37: sim export script, sim docs, URDF
    [budget19.urdf]
2026-11-10 v4 5/37: BOM generator, head STL
    [head.stl]
2026-11-10 v4 6/37: STL head_lid, l_ankle_link
    [head_lid.stl, l_ankle_link.stl]
2026-11-10 v4 7/37: STL l_finger, l_foot
    [l_finger.stl, l_foot.stl]
2026-11-10 v4 8/37: STL l_forearm
    [l_forearm.stl]
2026-11-10 v4 9/37: STL l_hip_roll_link, l_hip_yaw_link
    [l_hip_roll_link.stl, l_hip_yaw_link.stl]
2026-11-10 v4 10/37: STL l_shin, l_thigh
    [l_shin.stl, l_thigh.stl]
2026-11-10 v4 11/37: STL l_upper_arm, r_ankle_link
    [l_upper_arm.stl, r_ankle_link.stl]
2026-11-10 v4 12/37: STL r_finger, r_foot
    [r_finger.stl, r_foot.stl]
2026-11-10 v4 13/37: STL r_forearm
    [r_forearm.stl]
2026-11-10 v4 14/37: STL r_hip_roll_link, r_hip_yaw_link
    [r_hip_roll_link.stl, r_hip_yaw_link.stl]
2026-11-10 v4 15/37: STL r_shin, r_thigh
    [r_shin.stl, r_thigh.stl]
2026-11-10 v4 16/37: STL r_upper_arm
    [r_upper_arm.stl]
2026-11-10 v4 17/37: STL torso
    [torso.stl]
2026-11-10 v4 18/37: STEP battery_door, head, head_lid, l_ankle_link
    [battery_door.step, head.step, head_lid.step, l_ankle_link.step]
2026-11-10 v4 19/37: STEP l_finger, l_foot, l_forearm
    [l_finger.step, l_foot.step, l_forearm.step]
2026-11-10 v4 20/37: STEP l_hip_roll_link, l_hip_yaw_link
    [l_hip_roll_link.step, l_hip_yaw_link.step]
2026-11-10 v4 21/37: STEP l_shin, l_thigh
    [l_shin.step, l_thigh.step]
2026-11-10 v4 22/37: STEP l_upper_arm, r_ankle_link, r_finger
    [l_upper_arm.step, r_ankle_link.step, r_finger.step]
2026-11-10 v4 23/37: STEP r_foot, r_forearm
    [r_foot.step, r_forearm.step]
2026-11-10 v4 24/37: STEP r_hip_roll_link, r_hip_yaw_link
    [r_hip_roll_link.step, r_hip_yaw_link.step]
2026-11-10 v4 25/37: STEP r_shin, r_thigh
    [r_shin.step, r_thigh.step]
2026-11-10 v4 26/37: STEP r_upper_arm
    [r_upper_arm.step]
2026-11-10 v4 27/37: STEP torso
    [torso.step]
2026-11-10 v4 28/37: STEP torso_front_cover
    [torso_front_cover.step]
2026-11-10 v4 29/37: sim mesh base
    [base.obj]
2026-11-10 v4 30/37: sim meshes head, l_ankle_link, l_finger, l_foot
    [head.obj, l_ankle_link.obj, l_finger.obj, l_foot.obj]
2026-11-10 v4 31/37: sim meshes l_forearm, l_hip_roll_link, l_hip_yaw_link, l_shin
    [l_forearm.obj, l_hip_roll_link.obj, l_hip_yaw_link.obj, l_shin.obj]
2026-11-10 v4 32/37: sim meshes l_thigh, l_upper_arm, r_ankle_link, r_finger
    [l_thigh.obj, l_upper_arm.obj, r_ankle_link.obj, r_finger.obj]
2026-11-10 v4 33/37: sim meshes r_foot, r_forearm, r_hip_roll_link, r_hip_yaw_link
    [r_foot.obj, r_forearm.obj, r_hip_roll_link.obj, r_hip_yaw_link.obj]
2026-11-10 v4 34/37: sim meshes r_shin, r_thigh, r_upper_arm
    [r_shin.obj, r_thigh.obj, r_upper_arm.obj]
